minisystem/810/README.md

SYSTEM80 810
======================================

VCO/VCF/VCA in Eurorack format. Currently under development.

Hardware design by Minisystem: info@system80.net

LICENSE
=======
cc by-nc-sa
https://creativecommons.org/licenses/by-nc-sa/4.0/
