minisystem/810/Panel/810.PNG

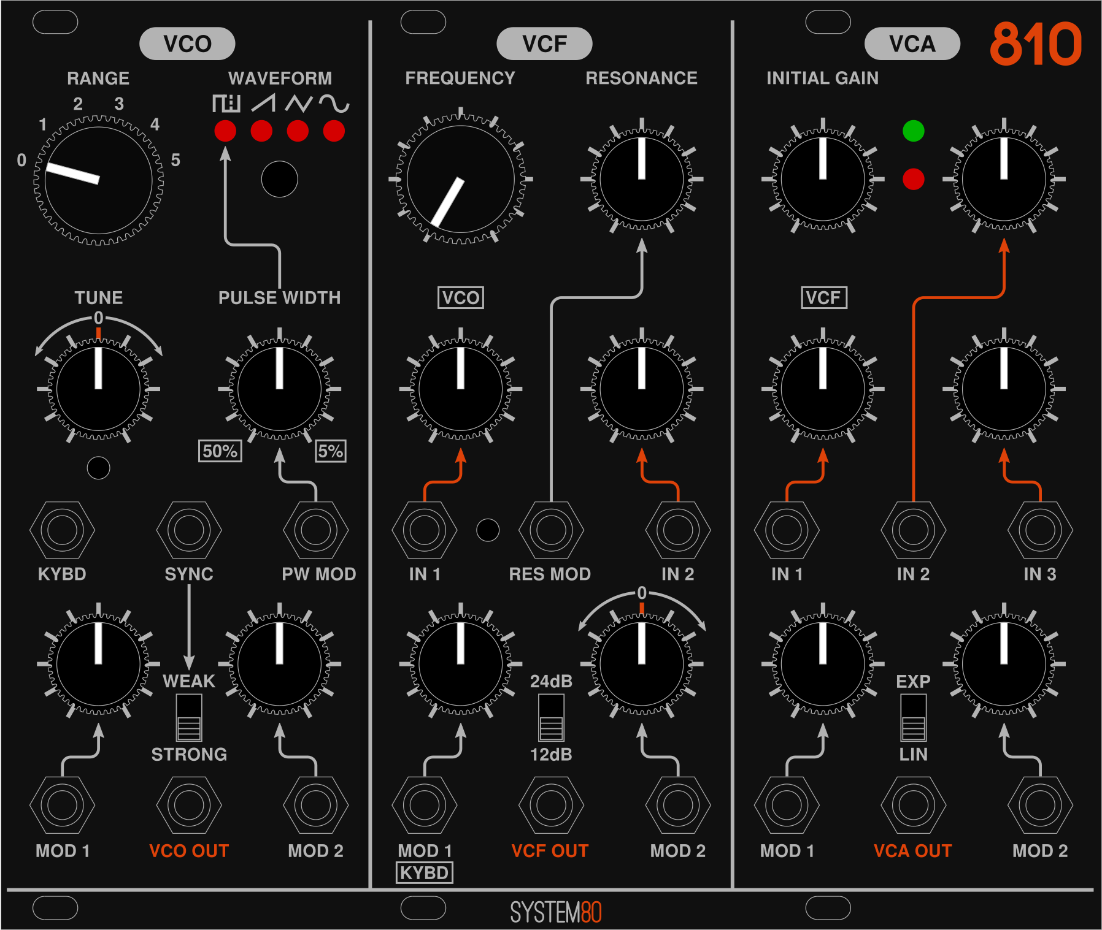
Panel/810.PNG
