minisystem/810/Panel/810_holes_centres_export_from_drawing.dxf

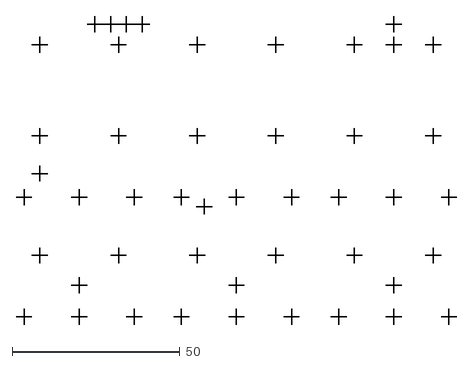
[picture p2: CAD file, 2018-02-21]
Panel/810_holes_centres_export_from_drawing.dxf
131.3 x 91.9
