minisystem/810/Panel/810_panel_mechanical.dxf

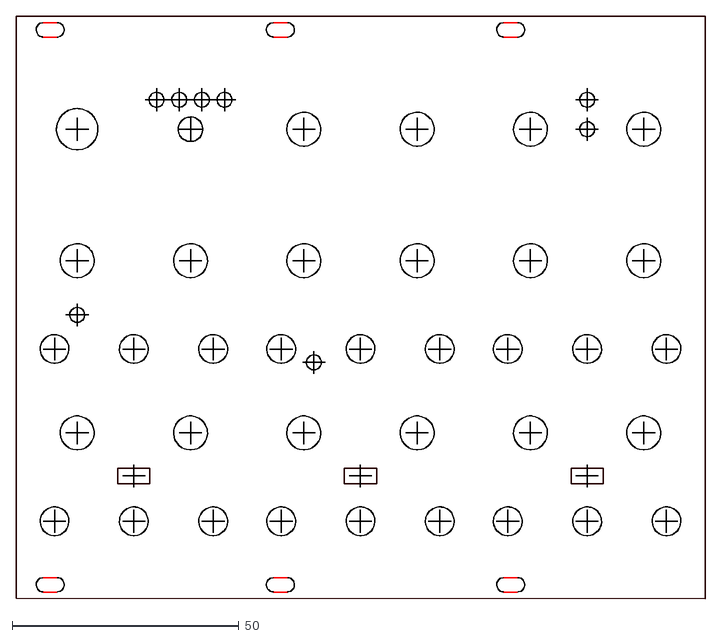
[picture p3: CAD file, 2018-02-21]
Panel/810_panel_mechanical.dxf
152.0 x 128.5
