minisystem/810/Panel/810_hole_centres.dxf

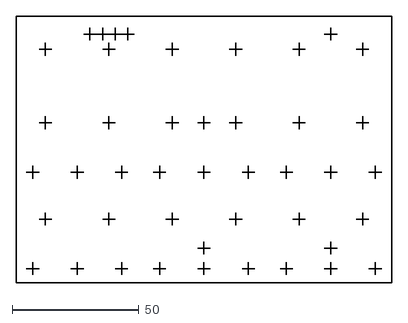
[picture p4: CAD file, 2017-09-25]
Panel/810_hole_centres.dxf
148.0 x 105.0
