minisystem/810/(list of files, cad)

Other CAD files:
Panel/810_panel_dimensioned.dwg
810-B.Paste.dxf
Panel/810_panel_mechanical.dwg
