minisystem/810/Panel/810_panel_dimensioned.pdf

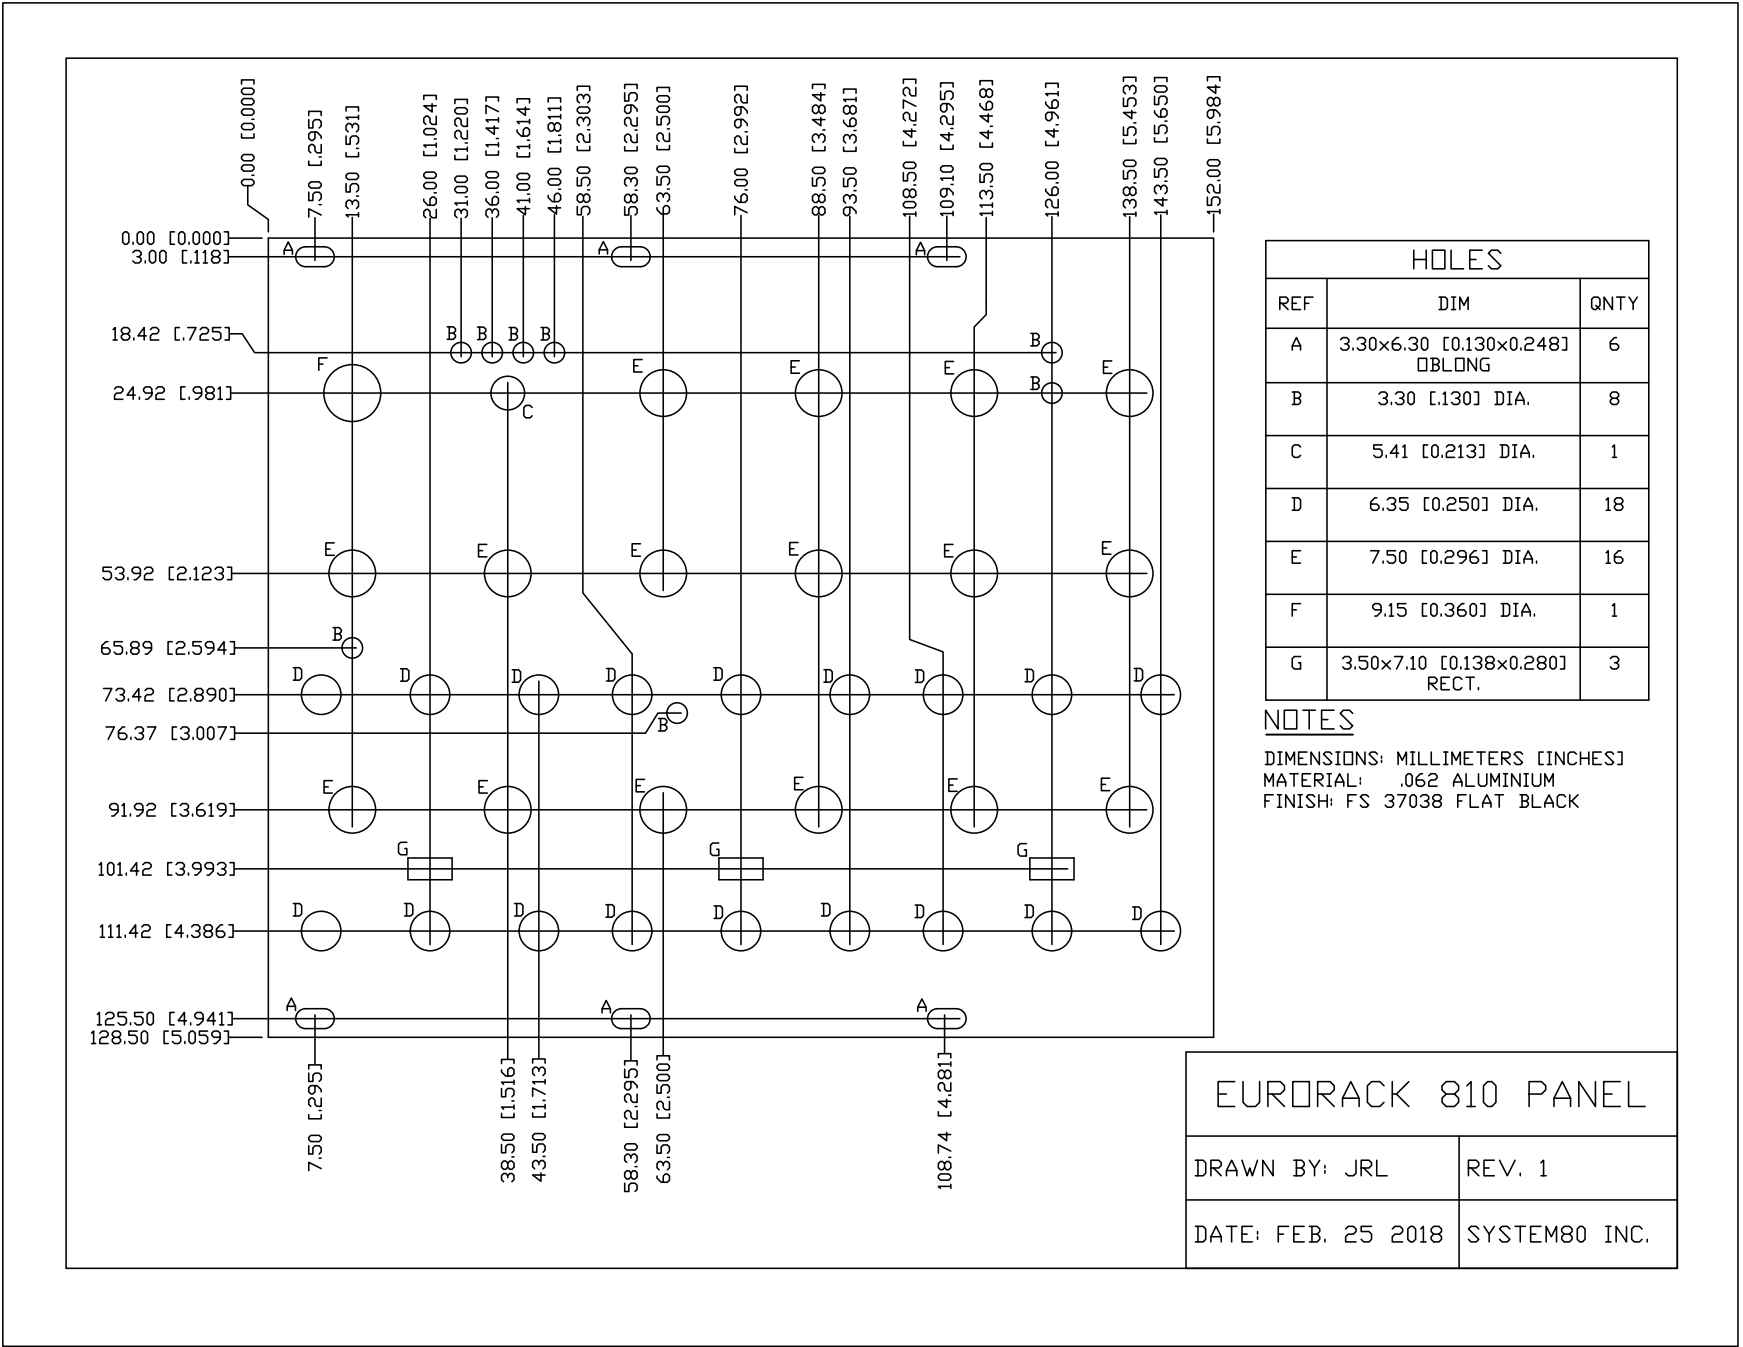
[picture p5: page 1]
