minisystem/810/Panel/810.pdf

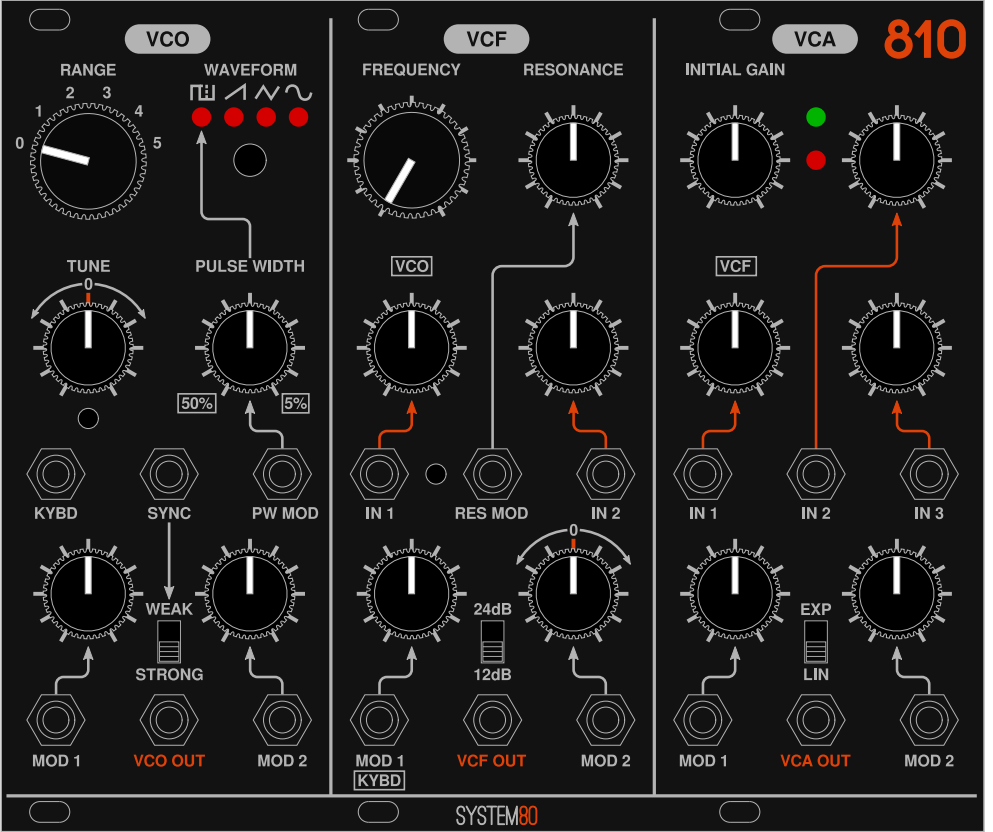
[picture p6: page 1]
