minisystem/810/Manual/810_manual_back_cover.pdf

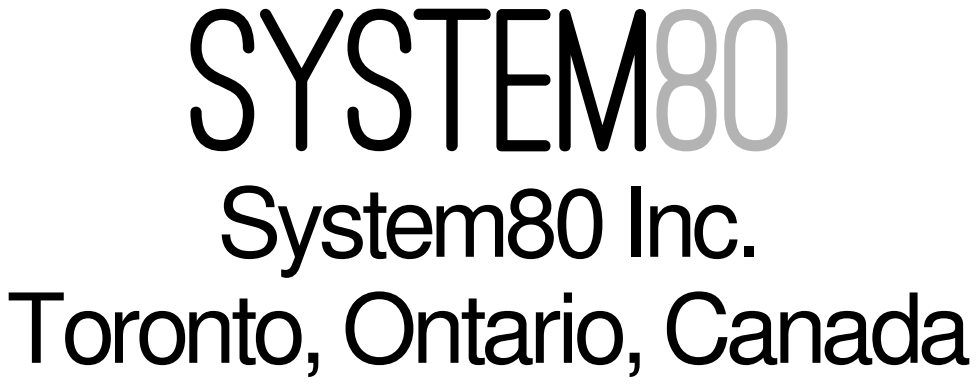
[picture p7: page 1]
