minisystem/810/Manual/810_manual_calibration.pdf

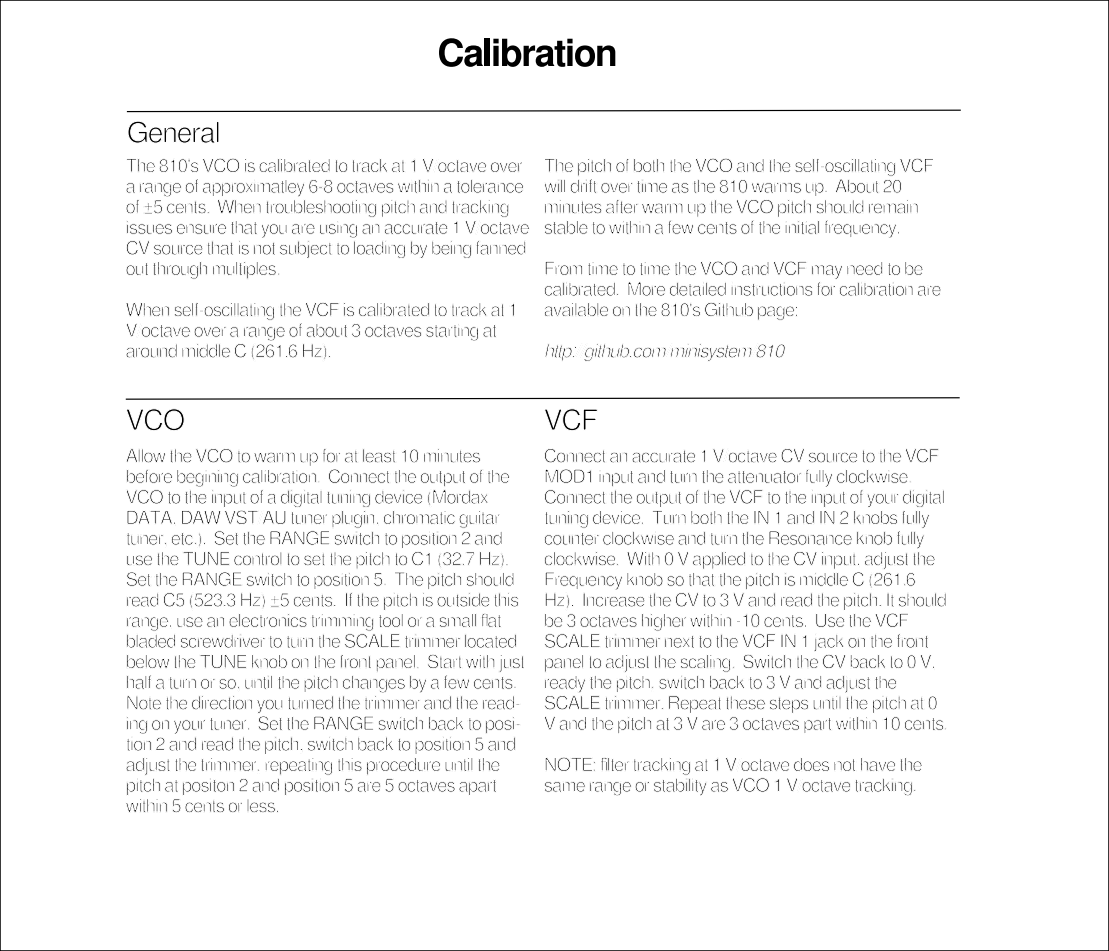
[picture p8: page 1]
