minisystem/810/Manual/810_manual_cover.pdf

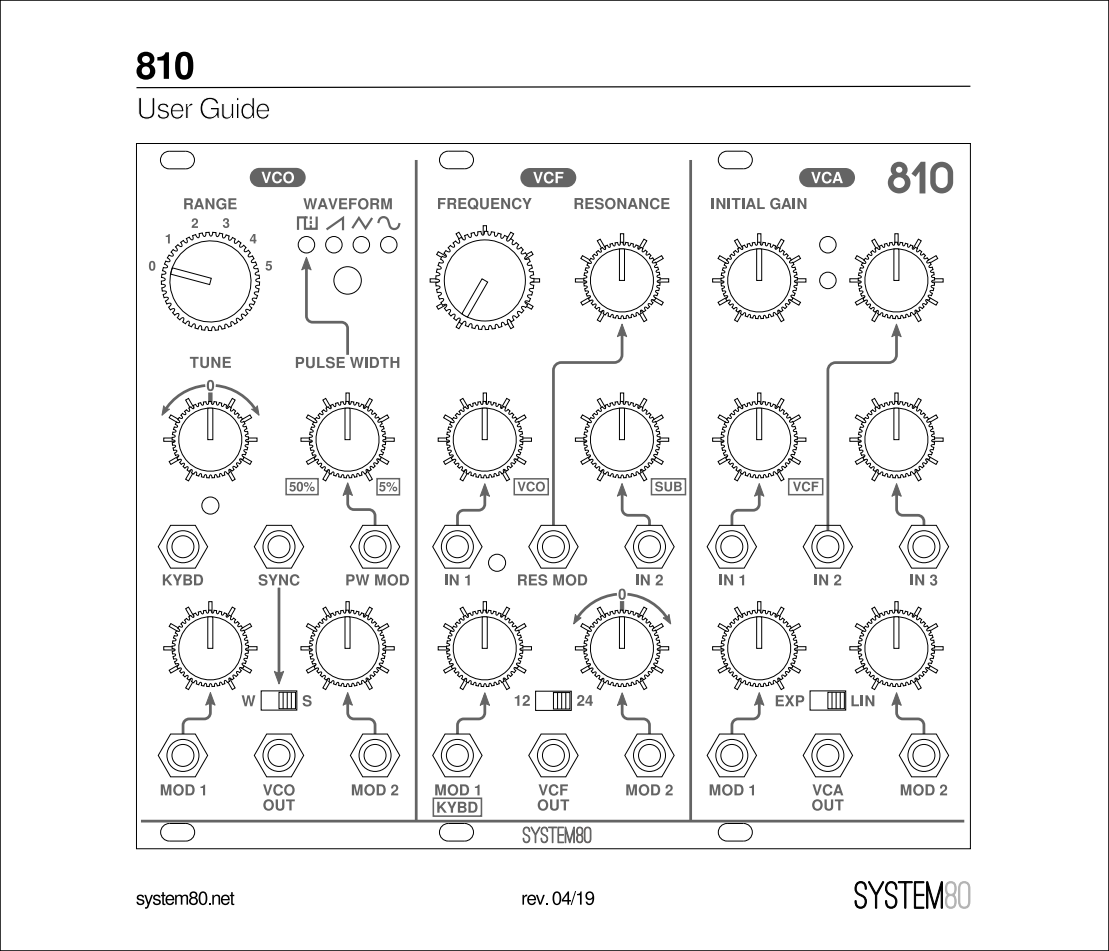
[picture p9: page 1]
