minisystem/810/Manual/810_manual_overview.pdf

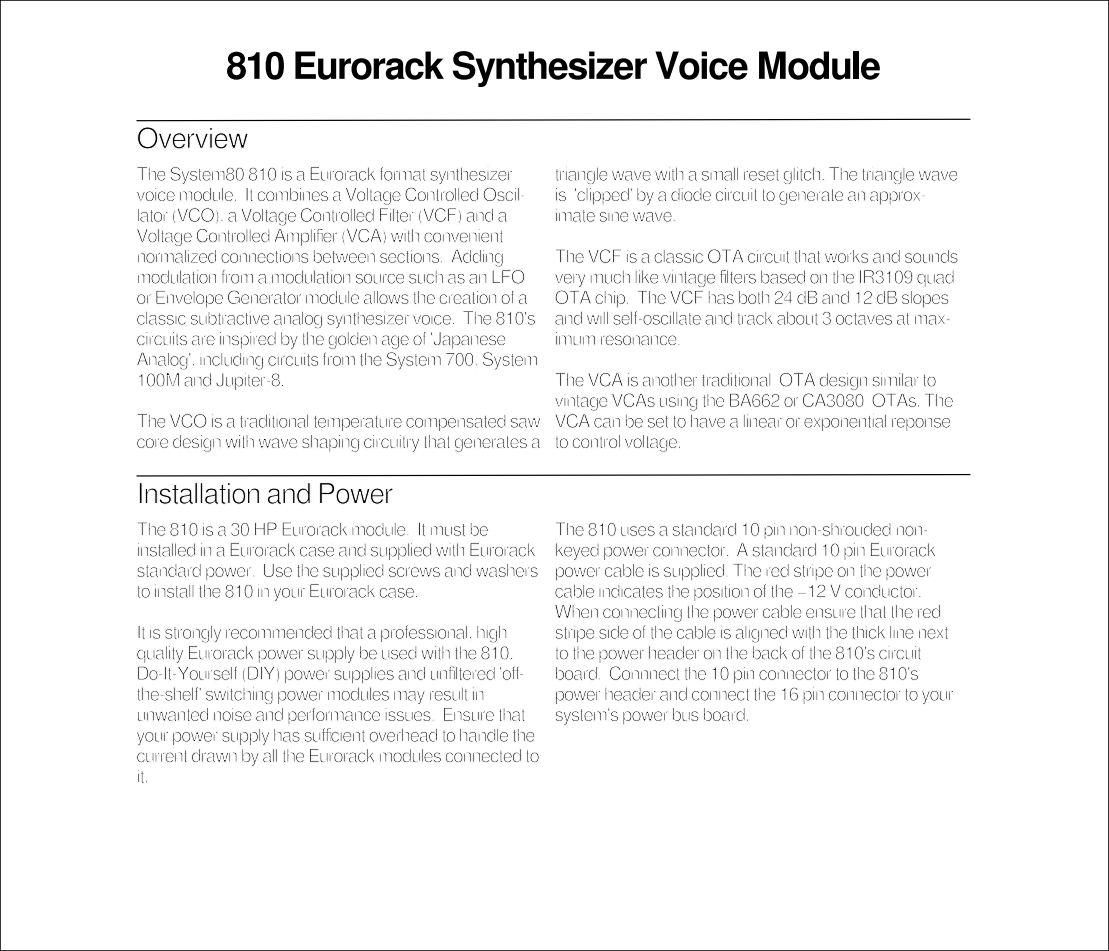
[picture p10: page 1]
