minisystem/810/Manual/810_manual_specifications.pdf

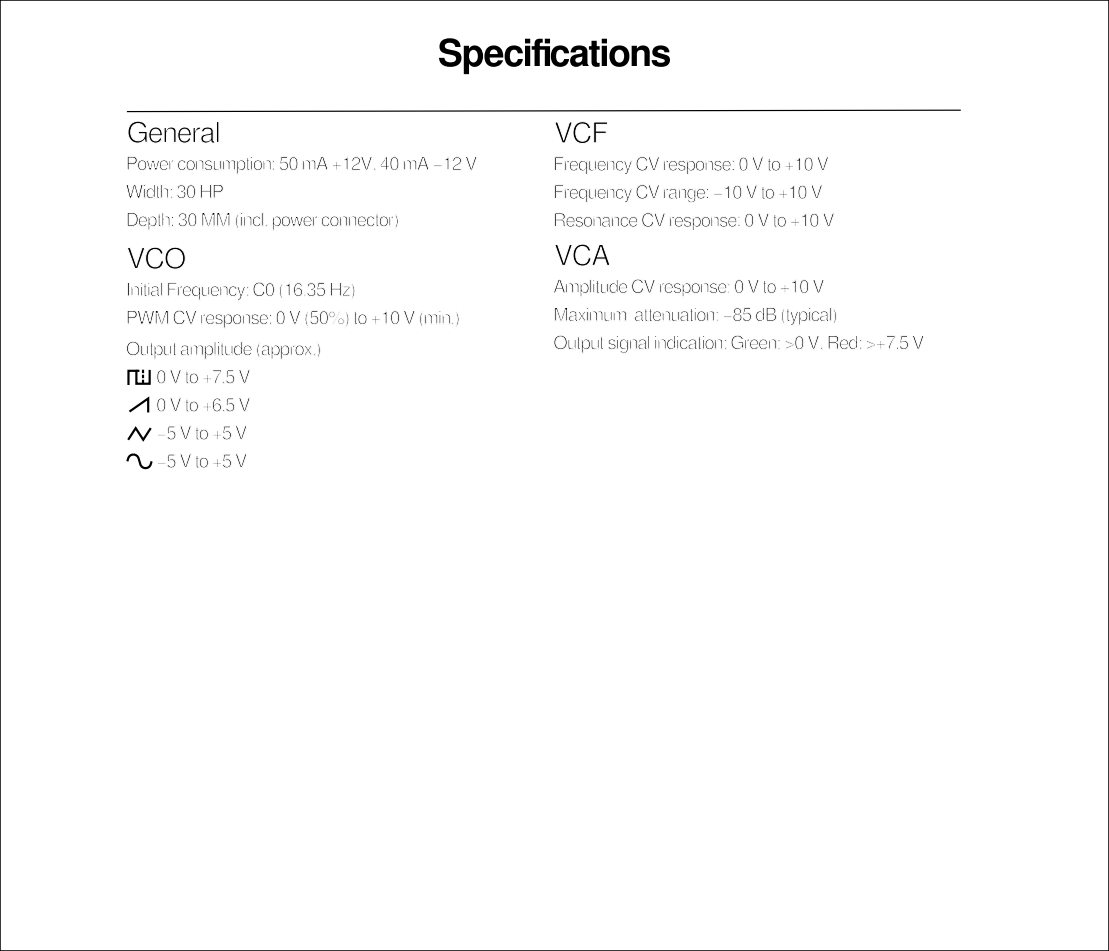
[picture p11: page 1]
