minisystem/810/Manual/810_manual_vca.pdf

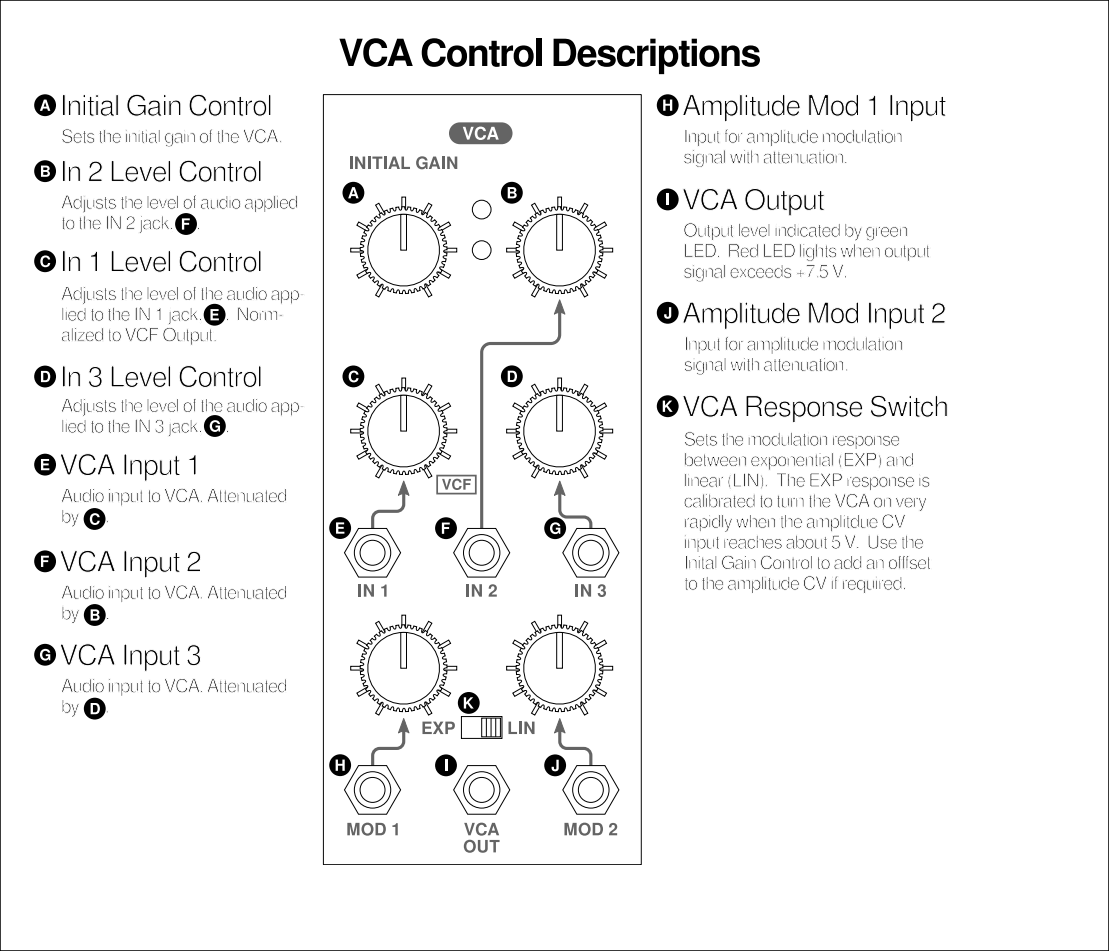
[picture p12: page 1]
