minisystem/810/Manual/810_manual_vcf.pdf

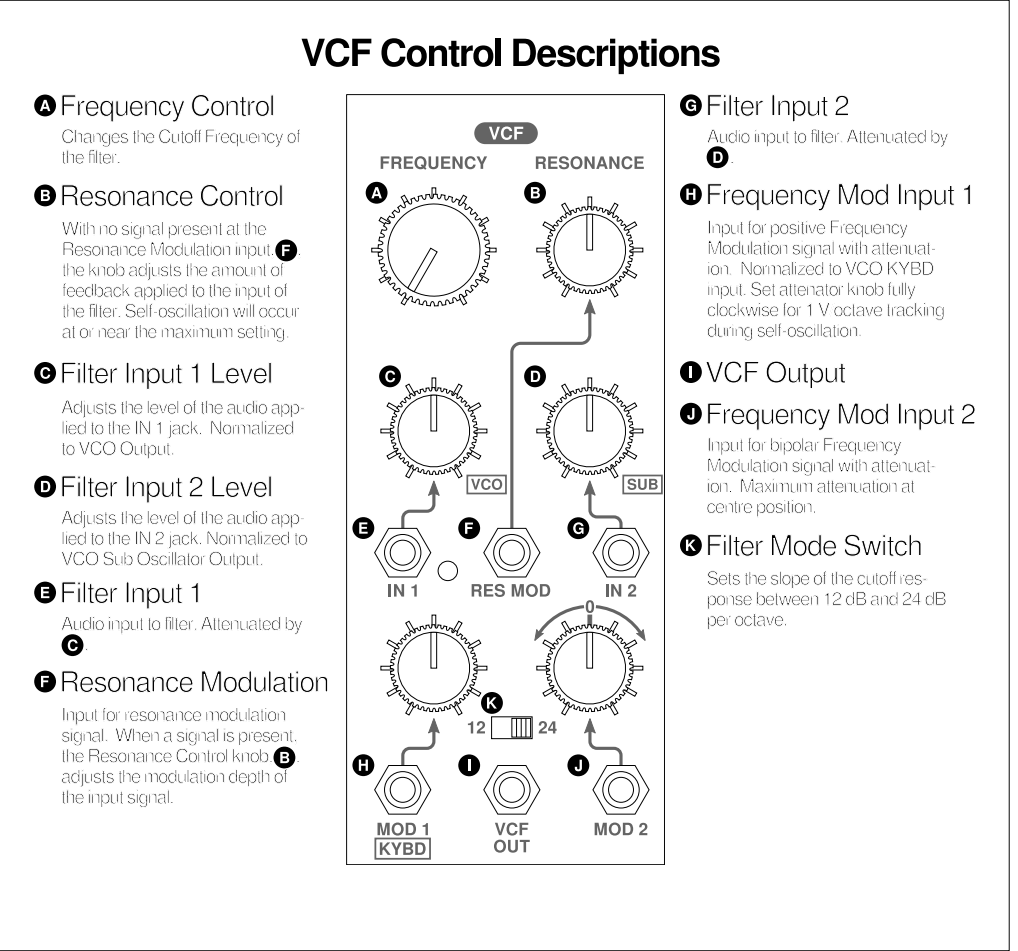
[picture p13: page 1]
