minisystem/810/Manual/810_manual_vco.pdf

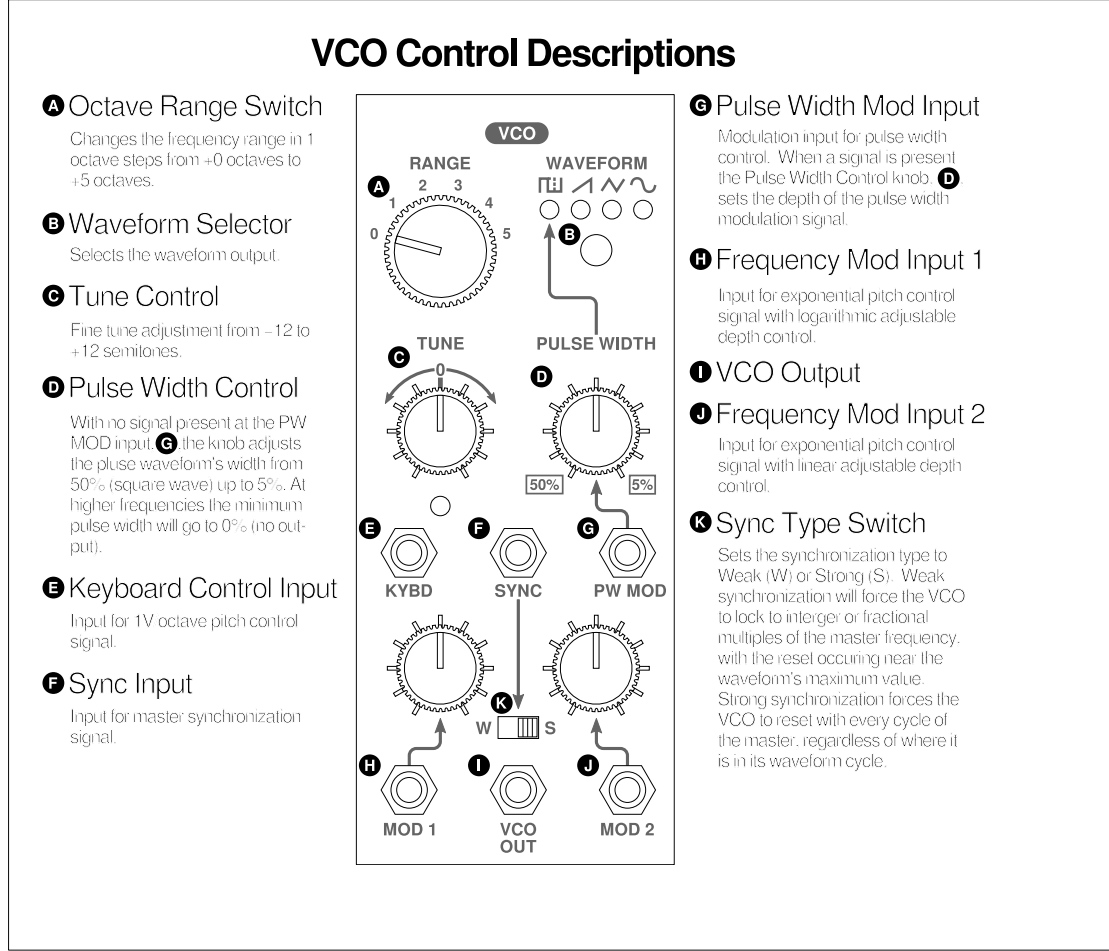
[picture p14: page 1]
