minisystem/810/810.kicad_pcb

## KiCad design 810.kicad_pcb (2018-04-28)

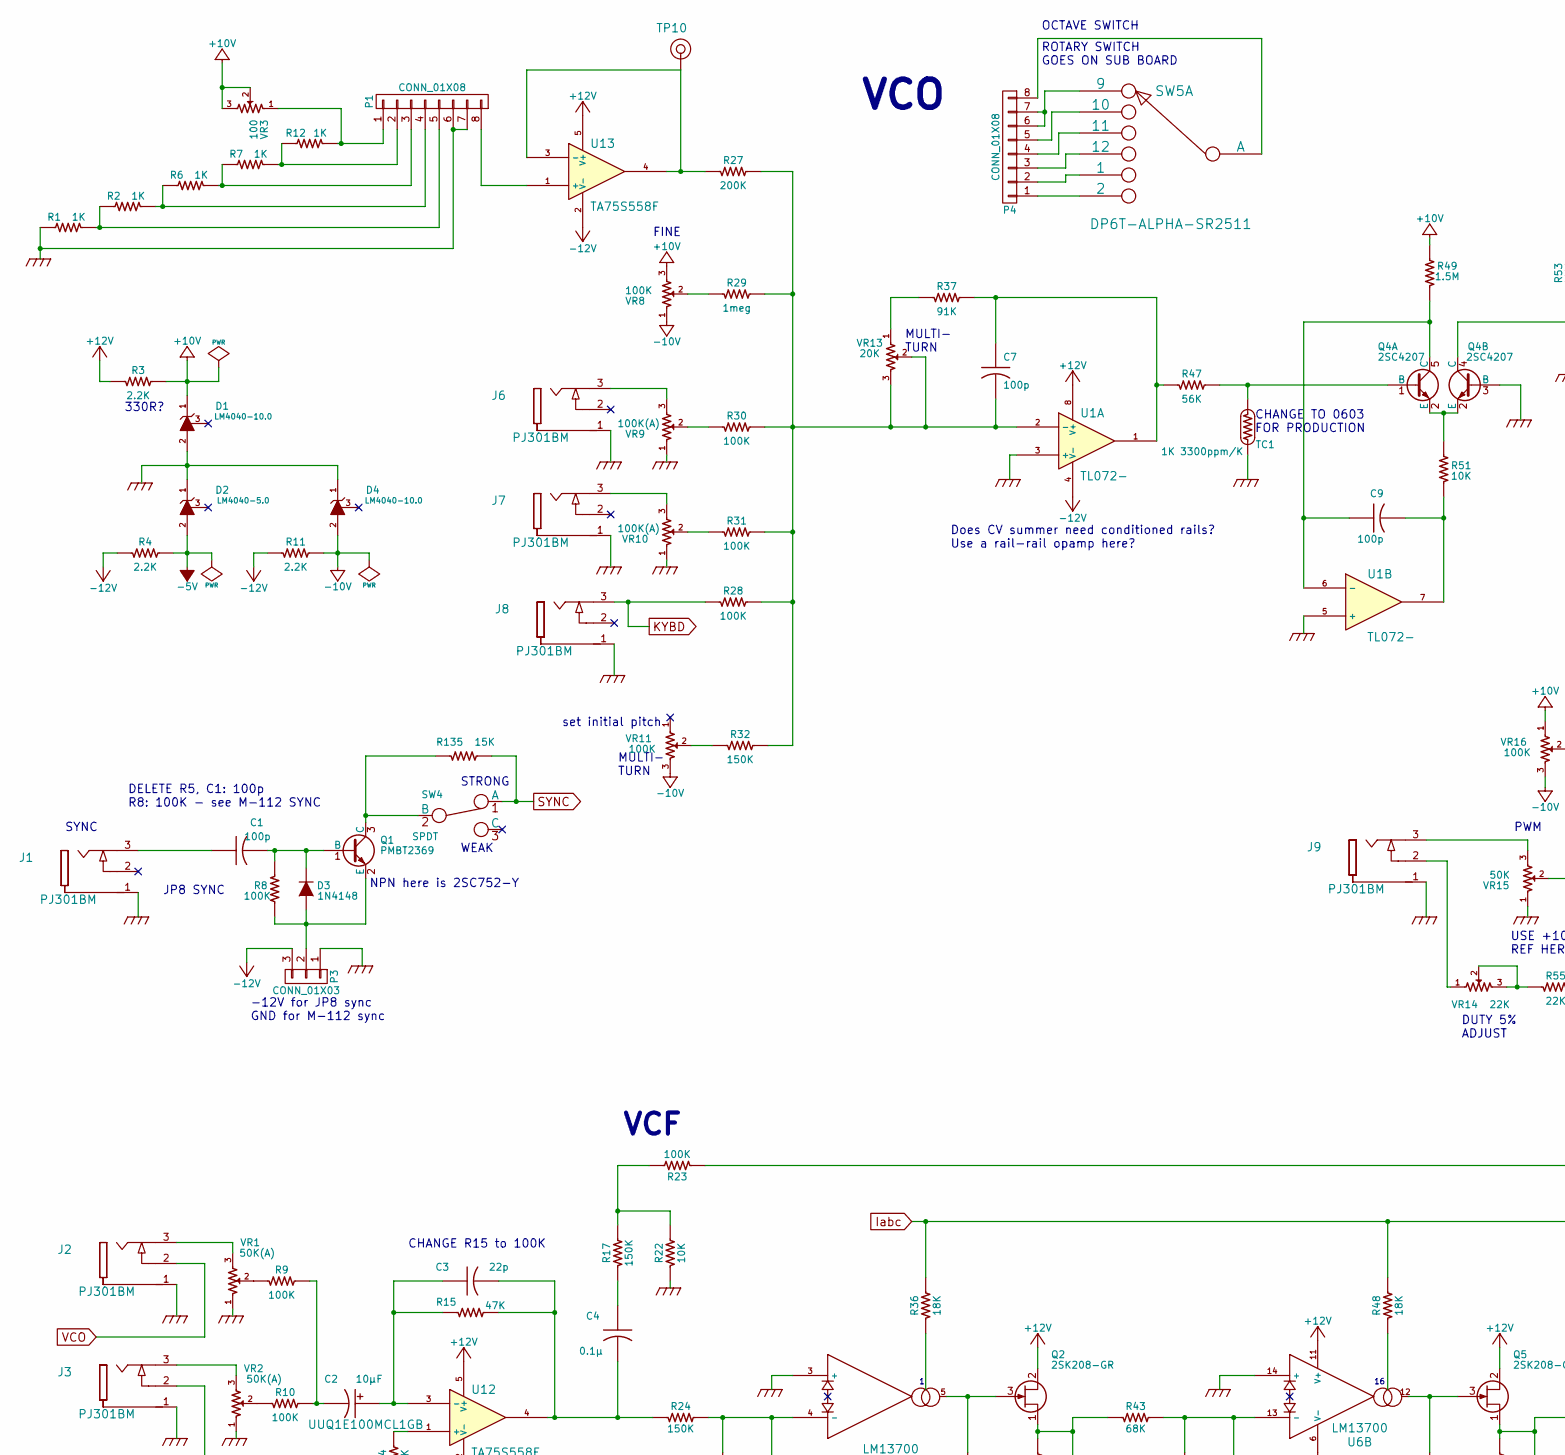
[picture p15: schematic 810.sch, part in row 1, column 1]

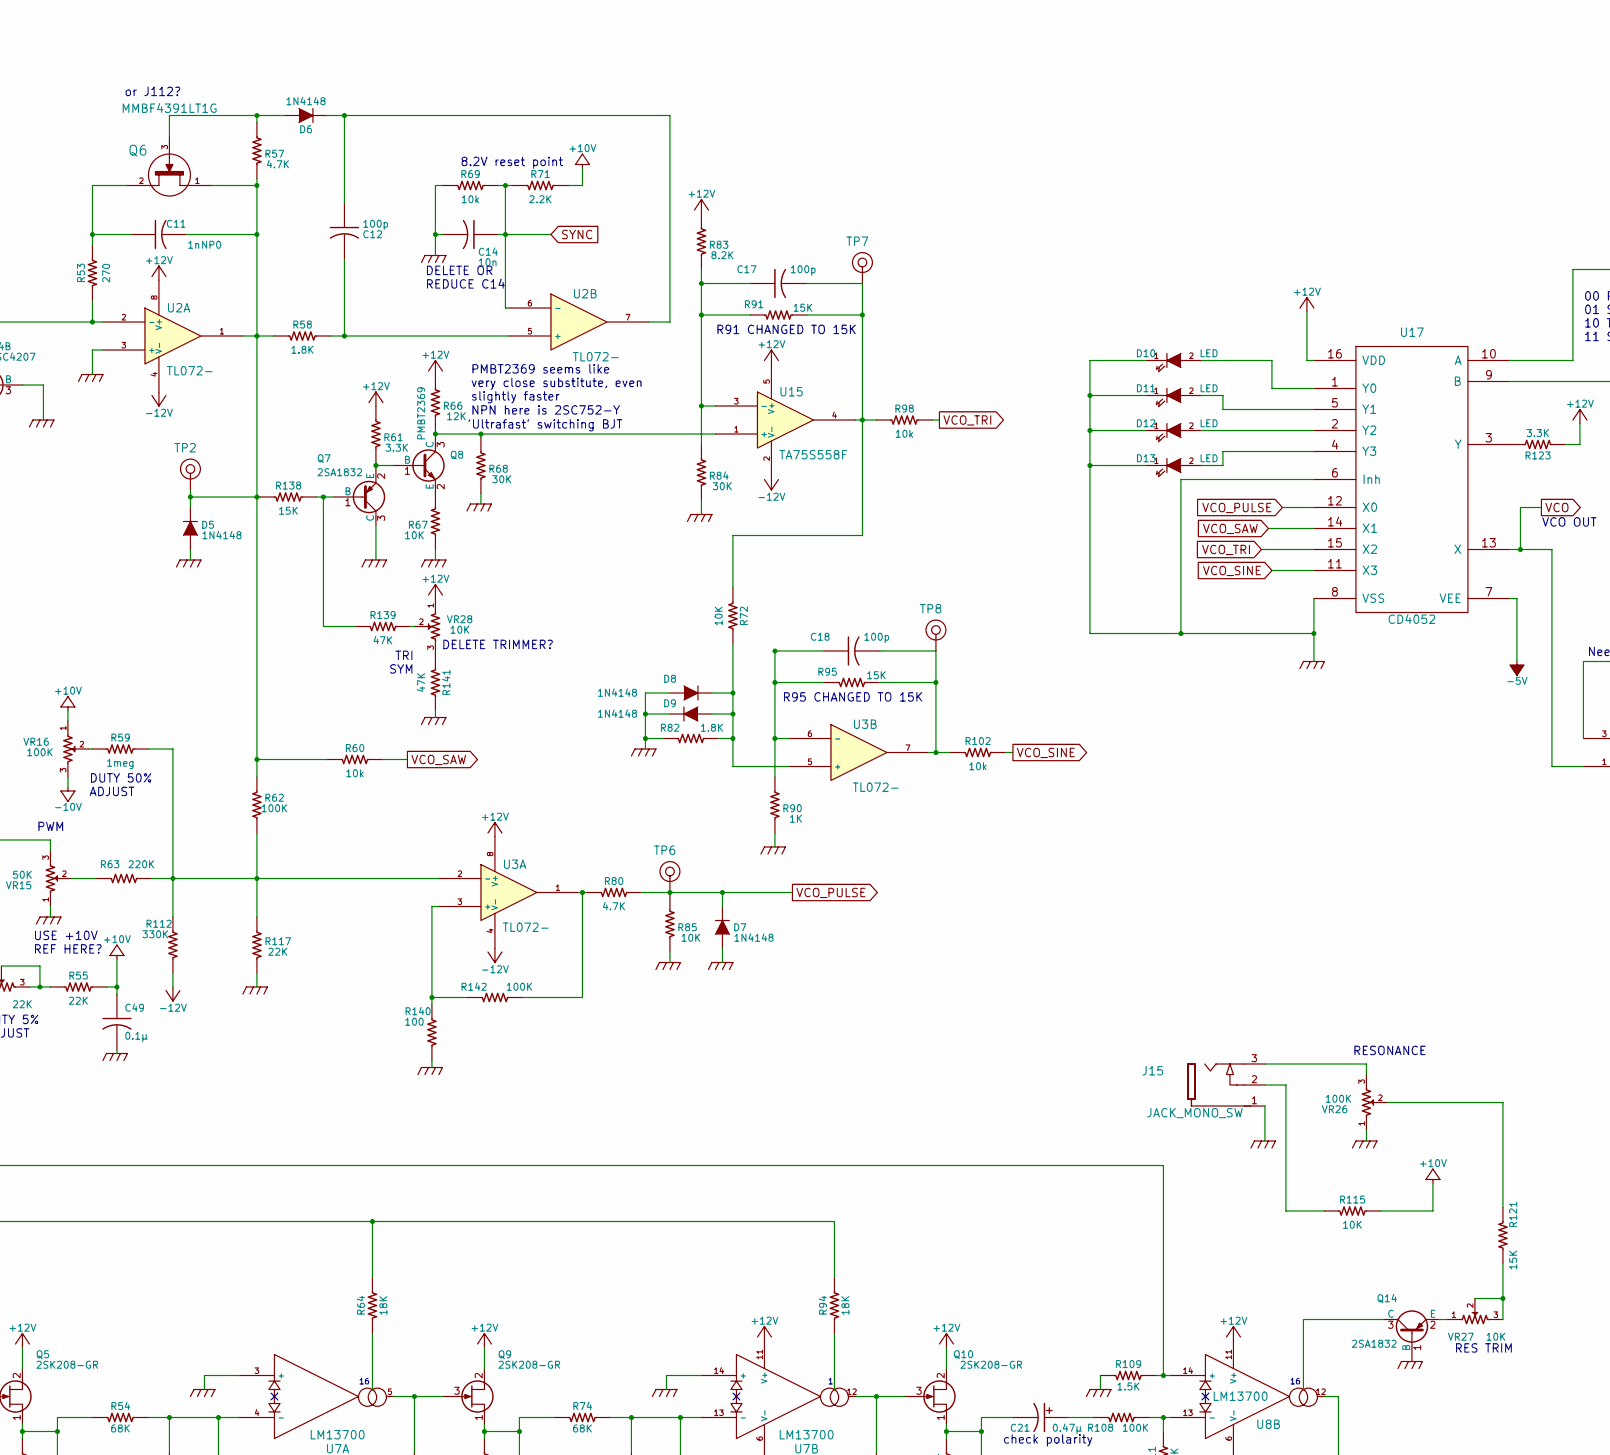
[picture p16: schematic 810.sch, part in row 1, column 2]

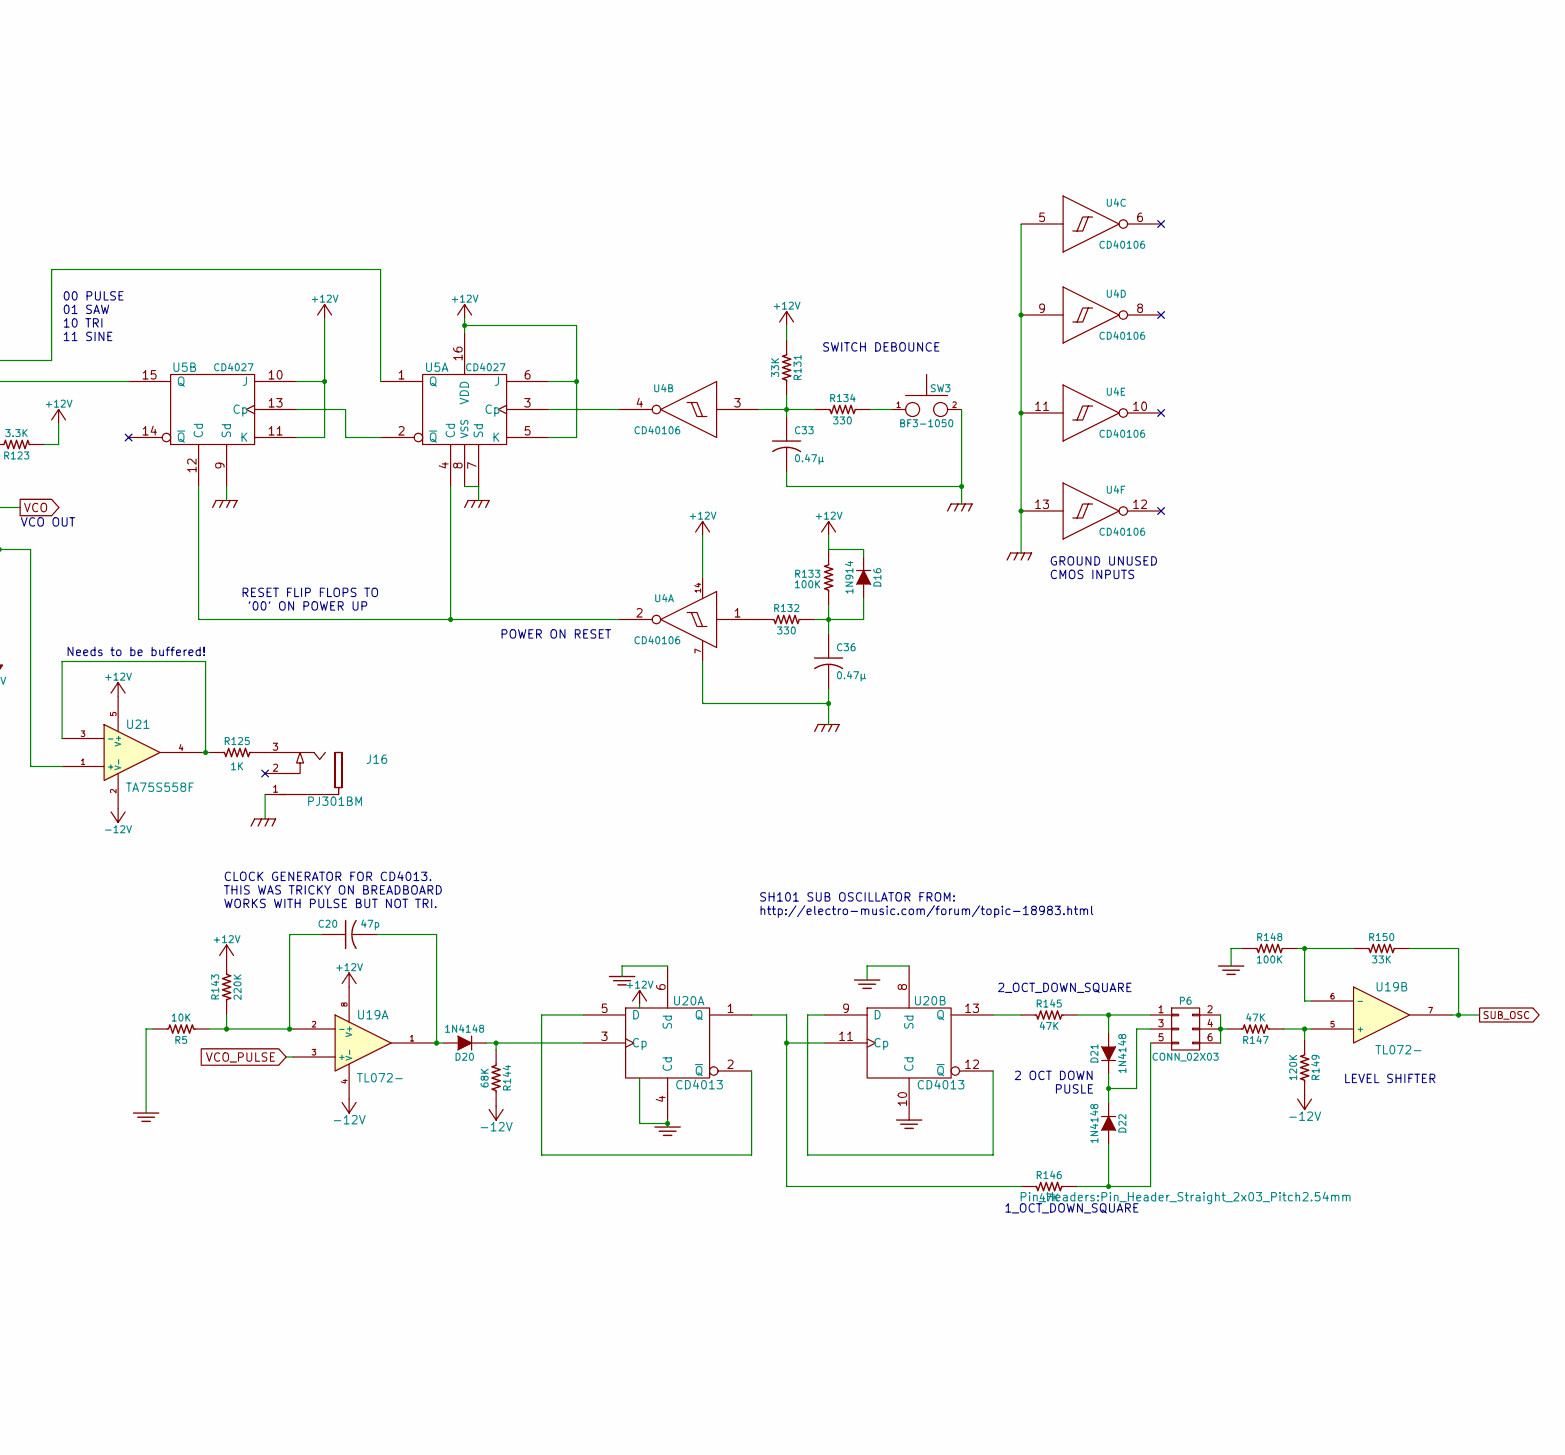
[picture p17: schematic 810.sch, part in row 1, column 3]

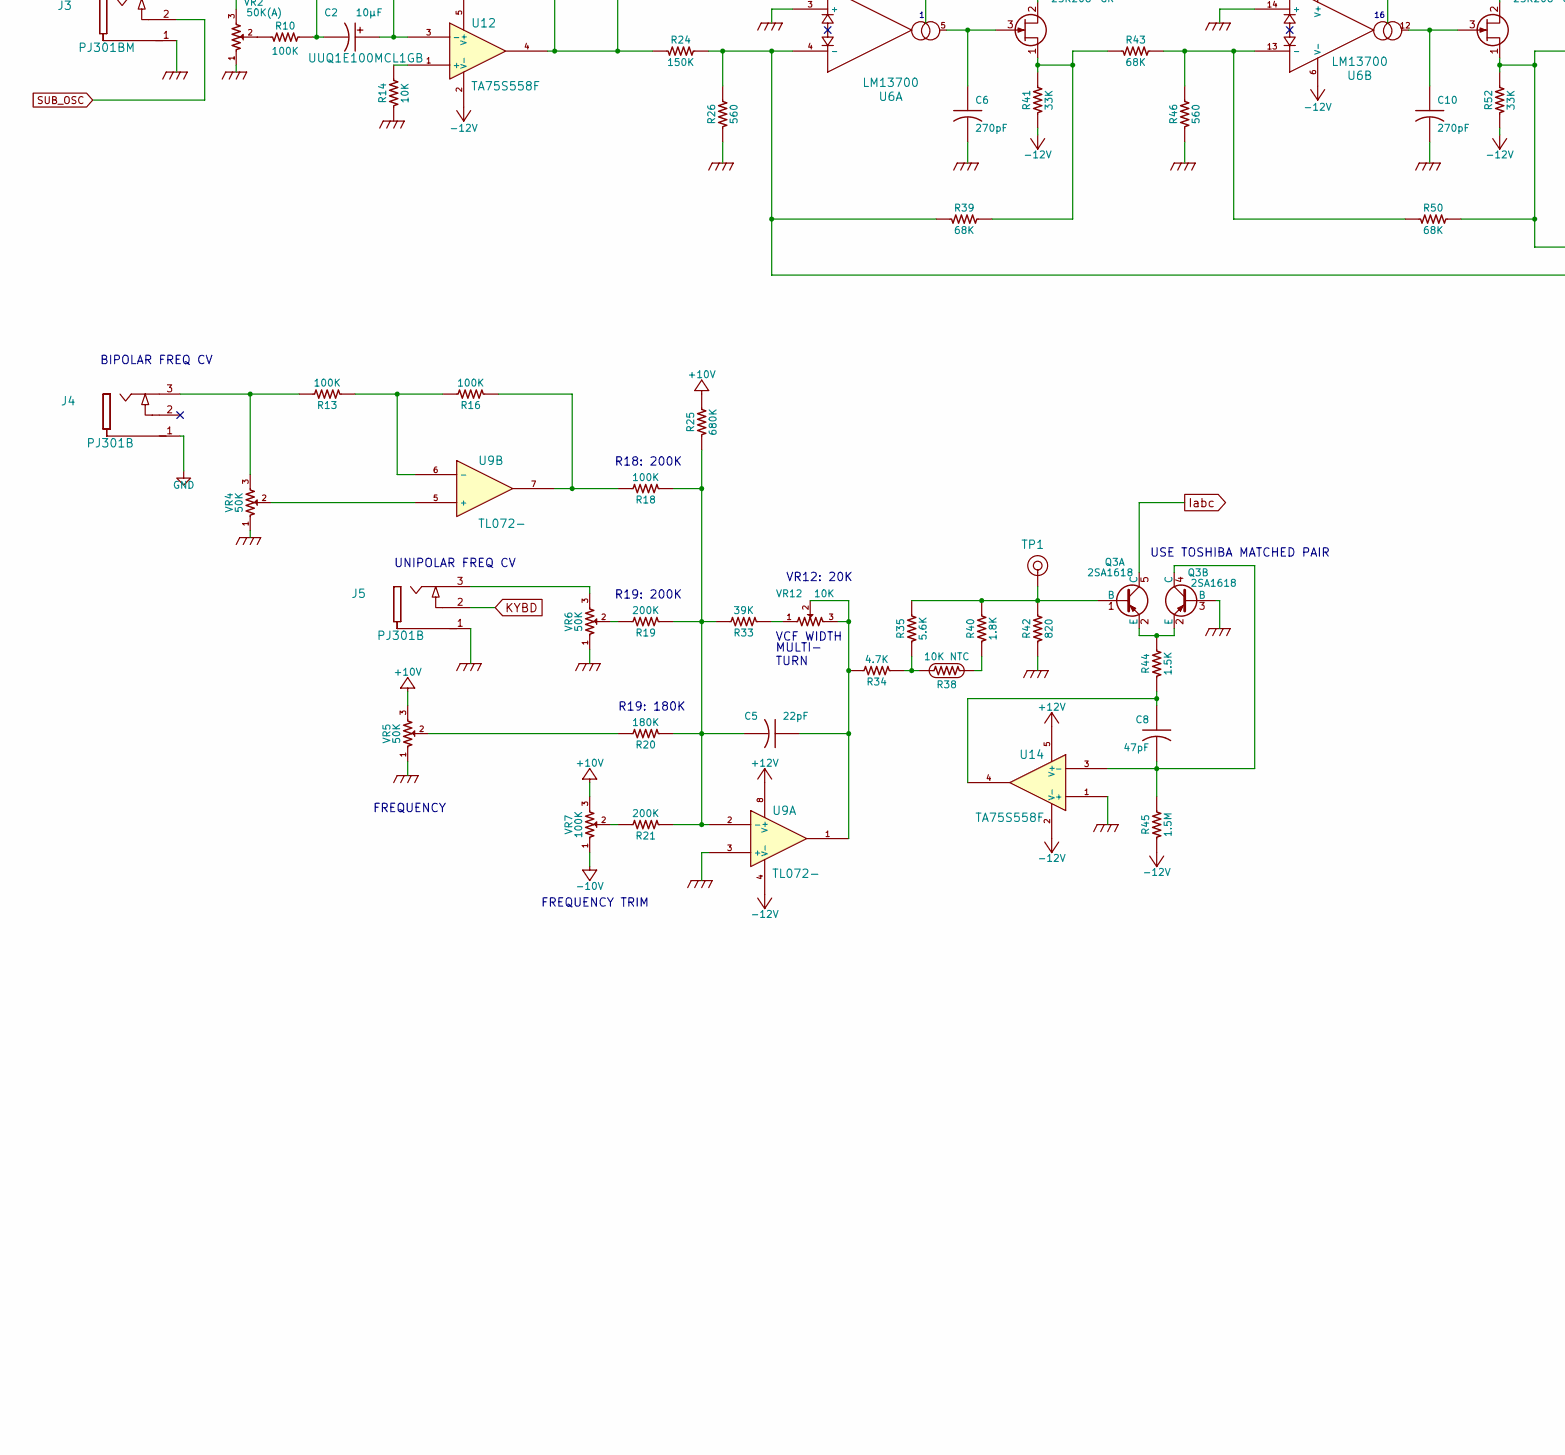
[picture p18: schematic 810.sch, part in row 2, column 1]

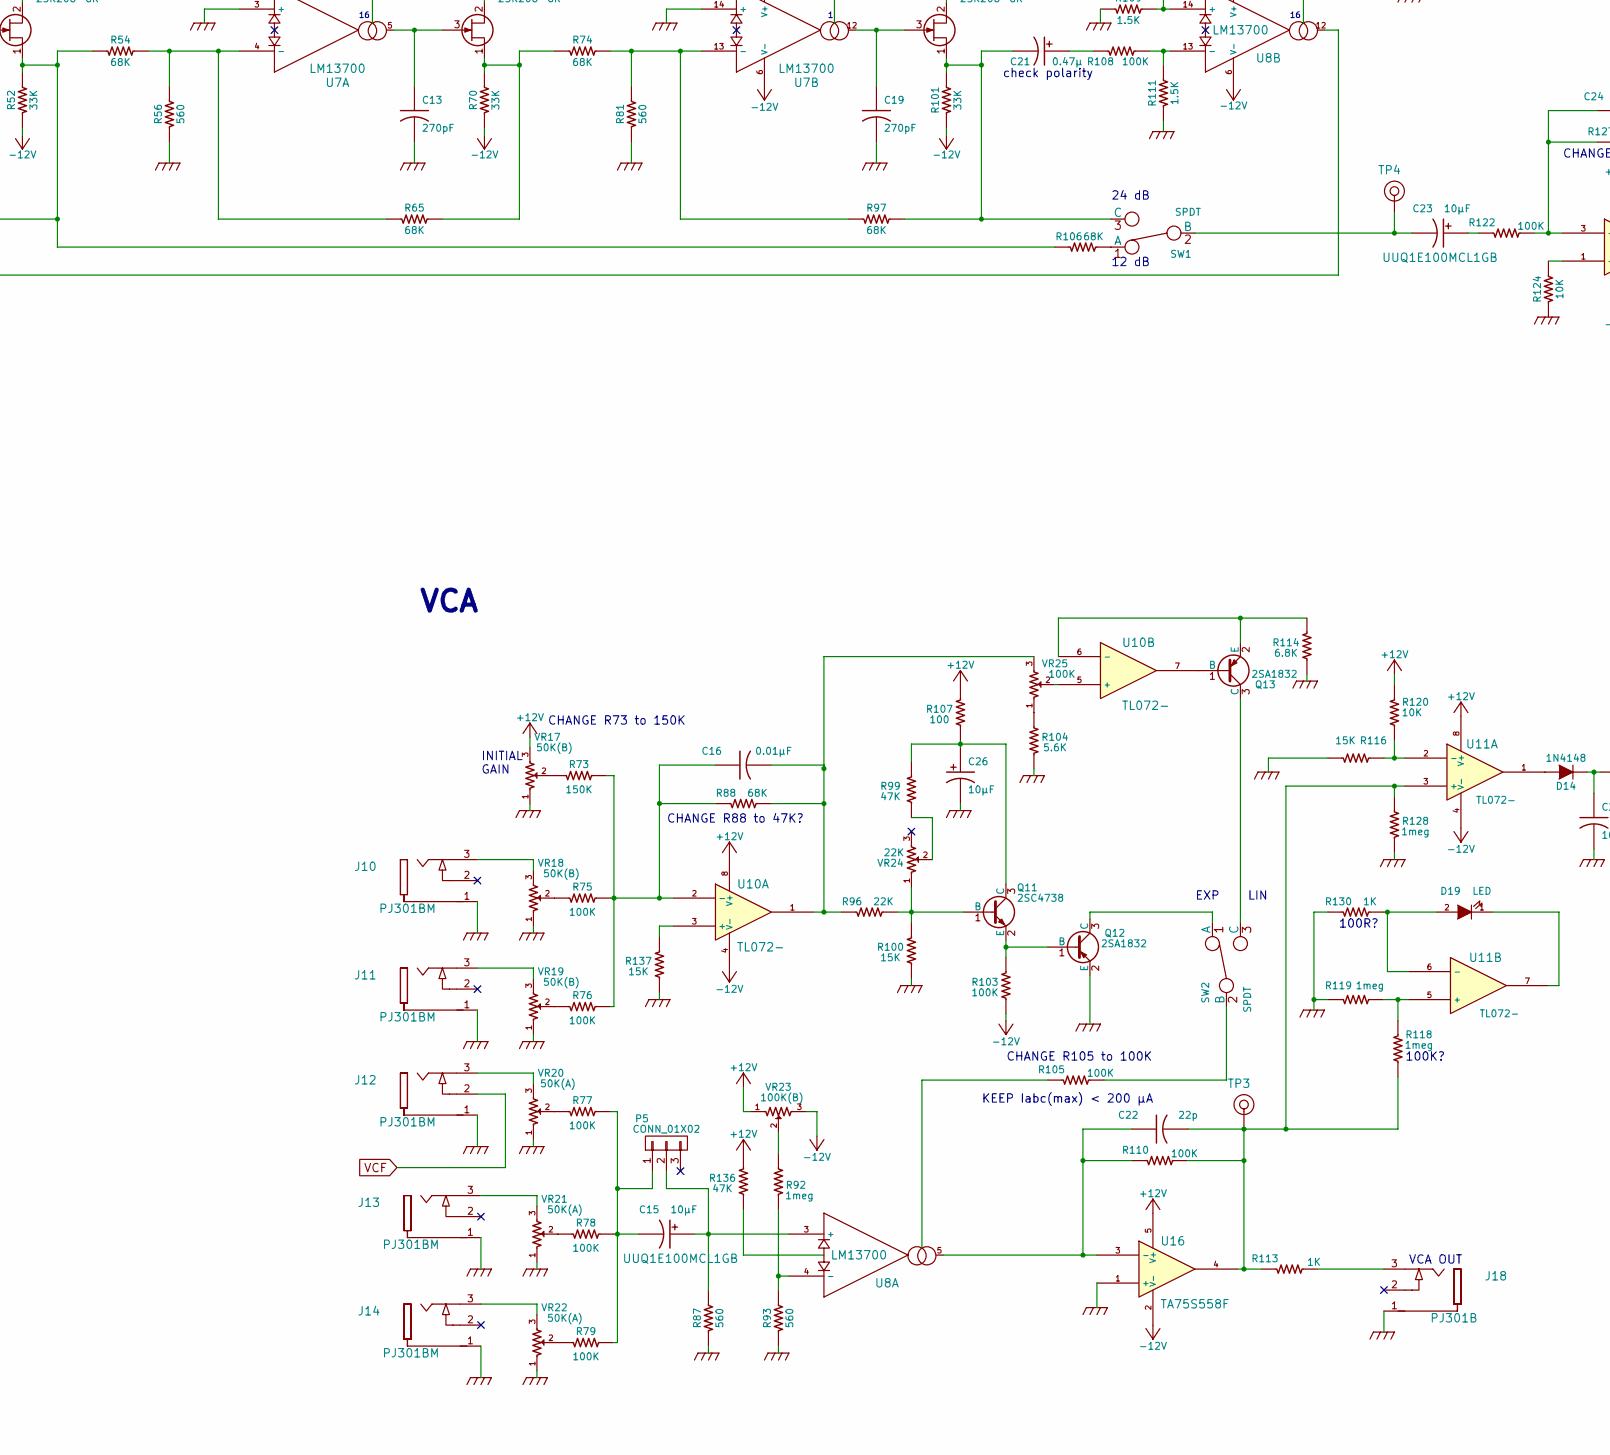
[picture p19: schematic 810.sch, part in row 2, column 2]

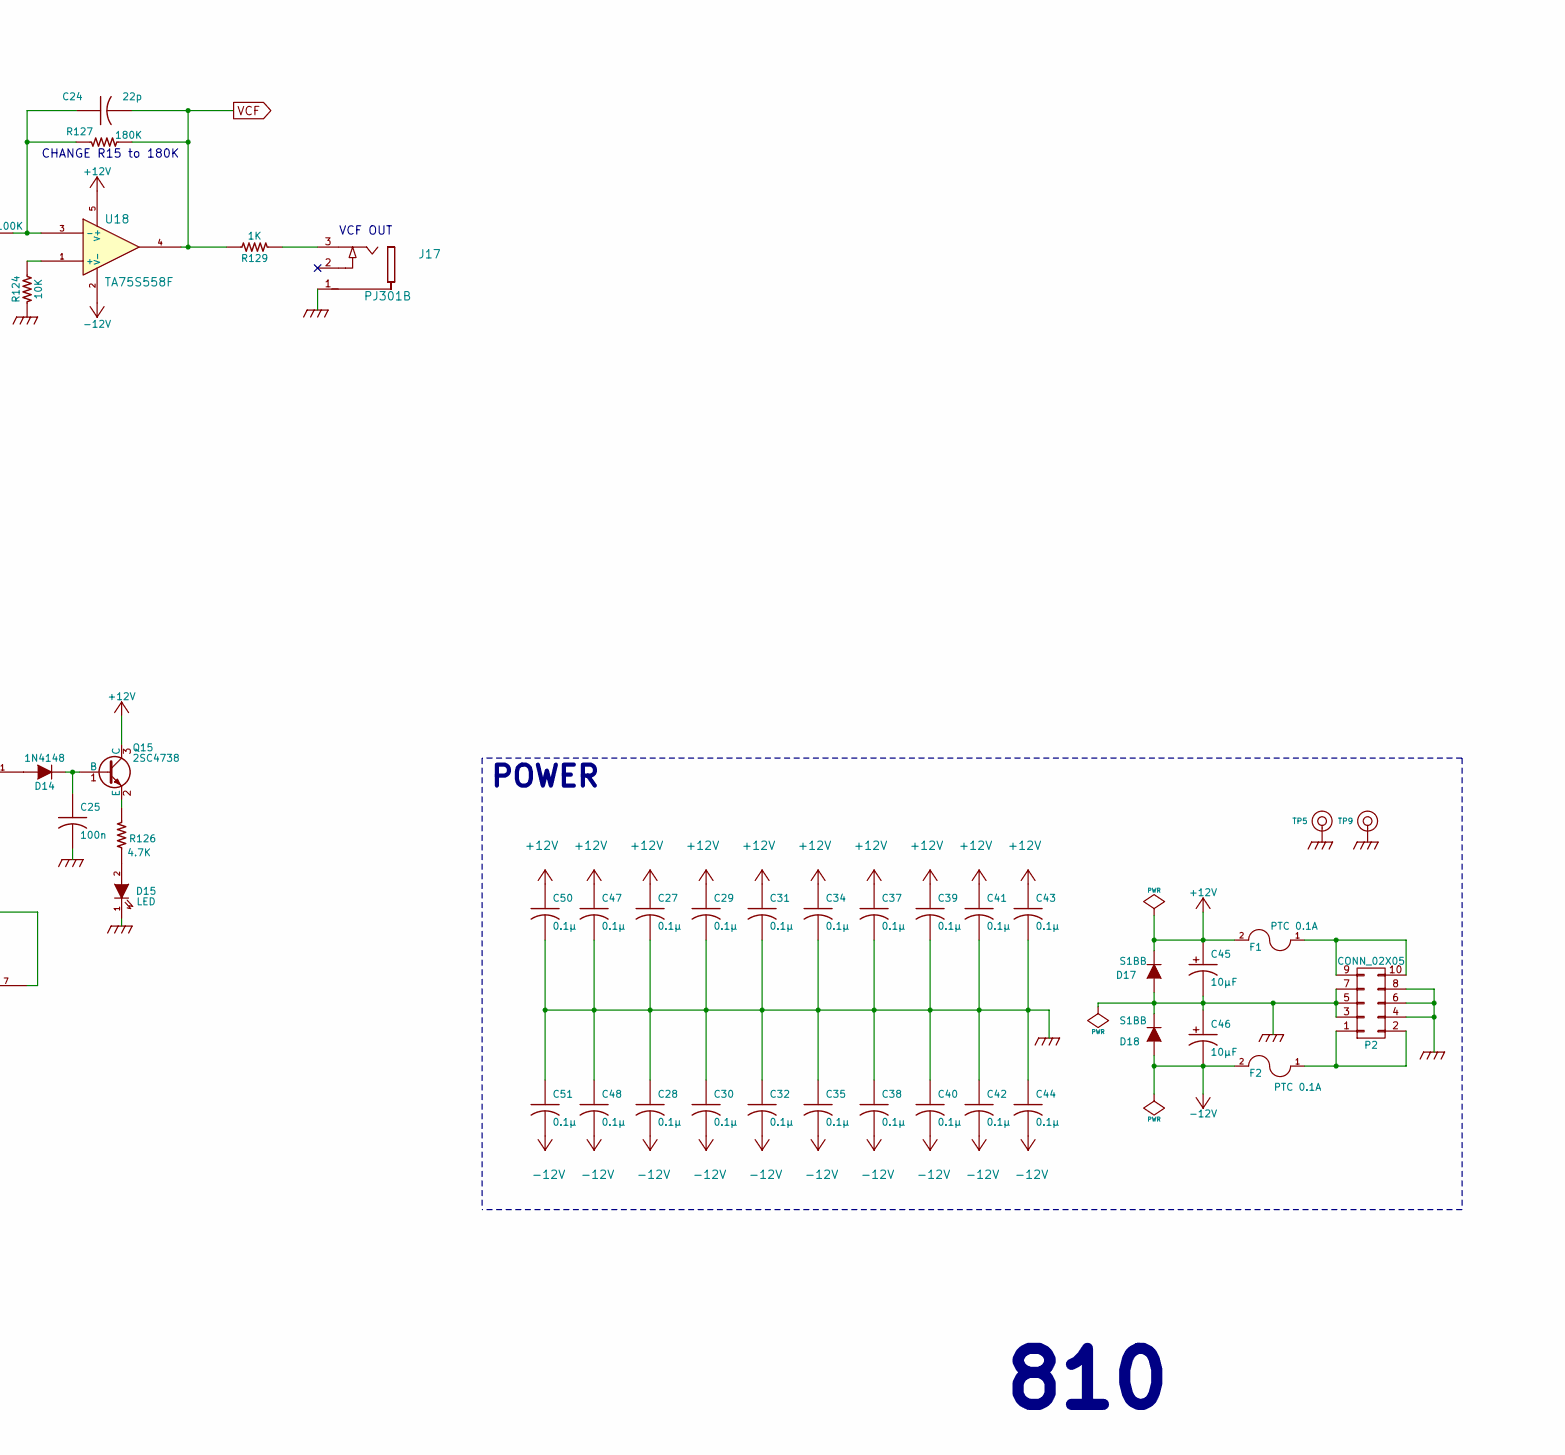
[picture p20: schematic 810.sch, part in row 2, column 3]

Parts:
C1, C12, C17, C18: 100p; SM0603-C-JRL
C2, C15, C23: 10μF; jrl_c_elec_5x5.3; Part Number UUQ1E100MCL1GB
C3, C22, C24: 22p; SM0603-C-JRL
C4: 0.1μ; SM0603-C-JRL
C5: 22pF; SM0603-C-JRL
C6, C10, C13, C19: 270pF; SM0603-C-JRL
C7, C9: 100p; SM0603-C-JRL; Digikey 399-1122-1-ND
C8: 47pF; SM0603-C-JRL
C11: 1n; SM0603-C-JRL
C14: 10n; SM0603-C-JRL
C16: 0.01μF; SM0603-C-JRL
C20: 47p; SM0603-C-JRL
C21: 0.47μ; jrl_c_elec_4x5.3
C25: 100n; SM0603-C-JRL
C26, C45, C46: 10μF; jrl_c_elec_5x5.3
C27, C28, C29, C30, C31, C32, C34, C35, C37, C38, C39, C40, C41, C42, C43, C44, C47, C48, C49, C50, C51: 0.1µ; SM0603-C-JRL
C33, C36: 0.47μ; SM0603-C-JRL
D1, D4: LM4040-10.0; SOT23-132-JRL
D2: LM4040-5.0; SOT23-132-JRL
D3, D5, D6, D7, D8, D9, D14, D20, D21, D22: 1N4148; SOD323-C1A2
D10, D11, D12, D13, D15, D19: LED; 3MM-LED-C1A2
D16: 1N914; SOD323-C1A2
D17, D18: S1BB; SMB-1C2A
F1, F2: PTC 0.1A; C_0805
J1, J2, J3, J6, J7, J8, J9, J10, J11, J12, J13, J14, J16: PJ301BM; PJ-301B-JACK-SLOTS
J4, J5, J17, J18: PJ301B; PJ-301B-JACK-SLOTS
J15: JACK_MONO_SW; PJ-301B-JACK-SLOTS
P1, P4: CONN_01X08; Pin_Header_Straight_1x08_Pitch2.54mm
P2: CONN_02X05; Pin_Header_Straight_2x05_Pitch2.54mm
P3: CONN_01X03; Pin_Header_Straight_1x03_Pitch2.54mm
P5: CONN_01X02; Pin_Header_Straight_1x03_Pitch2.54mm
P6: CONN_02X03; Pin_Header_Straight_2x03_Pitch2.54mm
Q1: PMBT2369; SOT-23
Q2, Q9, Q10: 2SK208-GR; SOT-23
Q3: 2SA1618; SOT753_TSOP5_SC-74A
Q4: 2SC4207; SOT753_TSOP5_SC-74A
Q5: 2SK208-GR; SC-59
Q6: MMBF4391LT1G; SOT23-132-JRL
Q7, Q12, Q13, Q14: 2SA1832; SOT416-SC75
Q8: PMBT2369; SOT23-132-JRL
Q11, Q15: 2SC4738; SOT416-SC75
R1, R2, R6, R7, R12, R129: 1K; SM0603-R-JRL
R3, R4, R11, R71: 2.2K; SM0603-R-JRL; Digikey P10.0KCCT-ND
R5, R14, R22, R124: 10K; SM0603-R-JRL
R8, R62, R105, R110, R122, R142: 100K; SM0603-R-JRL; Digikey P10.0KCCT-ND
R9, R10, R28, R30, R31, R75, R76, R77, R78, R79: 100K; SM0603-R-JRL; Digikey P91.0KCCT-ND
R13, R16, R18, R23, R103, R108, R133, R148: 100K; SM0603-R-JRL
R15, R139, R141: 47K; SM0603-R-JRL; Digikey P10.0KCCT-ND
R17, R24: 150K; SM0603-R-JRL
R19, R21: 200K; SM0603-R-JRL
R20: 180K; SM0603-R-JRL
R25: 680K; SM0603-R-JRL
R26, R46, R56, R81, R87, R93: 560; SM0603-R-JRL
R27: 200K; SM0603-R-JRL; Digikey P91.0KCCT-ND
R29: 1meg; SM0603-R-JRL; Digikey P91.0KCCT-ND
R32, R73: 150K; SM0603-R-JRL; Digikey P91.0KCCT-ND
R33: 39K; SM0603-R-JRL
R34: 4.7K; SM0603-R-JRL
R35, R104: 5.6K; SM0603-R-JRL
R36, R48, R64, R94: 18K; SM0603-R-JRL
R37: 91K; SM0603-R-JRL; Digikey P91.0KCCT-ND
R38: 10K NTC; SM0805-HAND
R39, R43, R50, R54, R65, R74, R97, R106, R144: 68K; SM0603-R-JRL
R40: 1.8K; SM0603-R-JRL
R41, R52, R70, R101, R131, R150: 33K; SM0603-R-JRL
R42: 820; SM0603-R-JRL
R44, R109, R111: 1.5K; SM0603-R-JRL
R45: 1.5M; SM0603-R-JRL
R47: 56K; SM0603-R-JRL; Digikey P56.0KCCT-ND
R49: 1.5M; SM0603-R-JRL; Digikey P1.50MCCT-ND
R51, R67, R72, R85, R115: 10K; SM0603-R-JRL; Digikey P10.0KCCT-ND
R53: 270; SM0603-R-JRL; Digikey P10.0KCCT-ND
R55: 22K; SM0603-R-JRL; Digikey P10.0KCCT-ND
R57, R80, R126: 4.7K; SM0603-R-JRL; Digikey P10.0KCCT-ND
R58, R82: 1.8K; SM0603-R-JRL; Digikey P10.0KCCT-ND
R59, R118, R119: 1meg; SM0603-R-JRL; Digikey P10.0KCCT-ND
R60, R69, R98, R102: 10k; SM0603-R-JRL; Digikey P10.0KCCT-ND
R61: 3.3K; SM0603-R-JRL; Digikey P10.0KCCT-ND
R63: 220K; SM0603-R-JRL; Digikey P10.0KCCT-ND
R66: 12K; SM0603-R-JRL; Digikey P10.0KCCT-ND
R68, R84: 30K; SM0603-R-JRL; Digikey P10.0KCCT-ND
R83: 8.2K; SM0603-R-JRL; Digikey P10.0KCCT-ND
R88: 68K; SM0603-R-JRL; Digikey P91.0KCCT-ND
R90, R113, R125: 1K; SM0603-R-JRL; Digikey P10.0KCCT-ND
R91, R95, R121, R135, R138: 15K; SM0603-R-JRL; Digikey P10.0KCCT-ND
R92, R128: 1meg; SM0603-R-JRL
R96: 22K; SM0603-R-JRL; Digikey P91.0KCCT-ND
R99, R136, R145, R146, R147: 47K; SM0603-R-JRL
R100, R116, R137: 15K; SM0603-R-JRL
R107: 100; SM0603-R-JRL
R112: 330K; SM0603-R-JRL; Digikey P10.0KCCT-ND
R114: 6.8K; SM0603-R-JRL
R117: 22K; SM0603-R-JRL
R120: 10K; SM0603-R-JRL; Digikey P91.0KCCT-ND
R123: 3.3K; SM0603-R-JRL
R127: 180K; SM0603-R-JRL; Digikey P10.0KCCT-ND
R130: 1K; SM0603-R-JRL; Digikey P91.0KCCT-ND
R132, R134: 330; SM0603-R-JRL
R140: 100; SM0603-R-JRL; Digikey P10.0KCCT-ND
R143: 220K; SM0603-R-JRL
R149: 120K; SM0603-R-JRL
SW1, SW2, SW4: SPDT; SS-12F108-1P2T-SLIDE
SW3: BF3-1050; B3F-1050-OMRON
SW5: DP6T-ALPHA-SR2511; SR2511-ALPHA
TC1: 1K 3300ppm/K; SM0805-HAND
TP1, TP2, TP3, TP4, TP6, TP7, TP8, TP10: TEST_POINT; TEST_POINT_5000_SERIES
TP5, TP9: CONN_1; TEST_POINT_LOOP_4592
U1, U2, U3, U9, U10, U19: TL072-; TSSOP8-JRL
U4: CD40106; TSSOP-14_4.4x5mm_Pitch0.65mm
U5: CD4027; TSSOP-16_4.4x5mm_Pitch0.65mm
U6, U7, U8: LM13700; SO16-JRL
U11: TL072-; TSSOP-8_4.4x3mm_Pitch0.65mm
U12, U13, U14, U15, U16, U18, U21: TA75S558F; SOT753_TSOP5_SC-74A
U17: CD4052; TSSOP-16_4.4x5mm_Pitch0.65mm
U20: CD4013; TSSOP-14_4.4x5mm_Pitch0.65mm
VR1, VR2, VR20, VR21, VR22: 50K(A); RD901F-ALPHA-POT-T18
VR3: 100; TC33X-2
VR4, VR5, VR6, VR15: 50K; RD901F-ALPHA-POT-T18
VR7, VR11, VR16, VR25: 100K; TC33X-2
VR8, VR26: 100K; RD901F-ALPHA-POT-T18
VR9, VR10: 100K(A); RD901F-ALPHA-POT-T18
VR12: 10K; Bourns-3296W
VR13: 20K; Bourns-3296W
VR14, VR24: 22K; TC33X-2
VR17, VR18, VR19: 50K(B); RD901F-ALPHA-POT-T18
VR23: 100K(B); TC33X-2
VR27, VR28: 10K; TC33X-2

Connections:
+10V: C49.1, D1.1 (K), R3.2, R25.2, R49.2, R55.2, R71.2, R115.2, VR3.2, VR3.3, VR5.3, VR7.3, VR8.3, VR16.1
+12V: C27.1, C29.1, C31.1, C34.1, C37.1, C39.1, C41.1, C43.1, C45.1 (+), C47.1, C50.1, D16.1 (K), D17.1 (K), F1.2, Q2.2 (S), Q5.2 (S), Q9.2 (S), Q10.2 (S), Q15.3 (C), R3.1, R61.2, R66.2, R83.2, R107.2, R120.1, R123.1, R131.2, R133.2, R136.2, R143.2, U1.8 (V+), U2.8 (V+), U3.8 (V+), U4.14 (VDD), U5.5 (K), U5.6 (J), U5.10 (J), U5.11 (K), U5.16 (VDD), U6.11 (V+), U7.11 (V+), U8.11 (V+), U9.8 (V+), U10.8 (V+), U11.8 (V+), U12.5 (V+), U13.5 (V+), U14.5 (V+), U15.5 (V+), U16.5 (V+), U17.16 (VDD), U18.5 (V+), U19.8 (V+), U20.14 (VDD), U21.5 (V+), VR17.3, VR23.1, VR28.1
-5V: D2.2 (A), R4.2, U17.7 (VEE)
-10V: D4.2 (A), R11.2, VR7.1, VR8.1, VR11.3, VR16.3
-12V: C28.2, C30.2, C32.2, C35.2, C38.2, C40.2, C42.2, C44.2, C46.2 (-), C48.2, C51.2, D18.2 (A), F2.2, P3.3, R4.1, R11.1, R41.1, R45.2, R52.1, R70.1, R101.1, R103.1, R112.2, R144.2, R149.2, U1.4 (V-), U2.4 (V-), U3.4 (V-), U6.6 (V-), U7.6 (V-), U8.6 (V-), U9.4 (V-), U10.4 (V-), U11.4 (V-), U12.2 (V-), U13.2 (V-), U14.2 (V-), U15.2 (V-), U16.2 (V-), U18.2 (V-), U19.4 (V-), U21.2 (V-), VR23.3
Iabc: Q3.5 (C), R36.2, R48.2, R64.2, R94.2
KYBD: J5.2, J8.3, R28.1
unnamed: C1.1, J1.3
unnamed: C1.2, D3.1 (K), Q1.1 (B), R8.2
unnamed: C2.1 (+), C3.1, R15.1, U12.3 (-)
unnamed: C2.2 (-), R9.2, R10.2
unnamed: C3.2, C4.2, R15.2, R24.1, U12.4
unnamed: C4.1, R17.1
unnamed: C5.1, R34.2, U9.1, VR12.2, VR12.3
unnamed: C5.2, R18.1, R19.1, R20.1, R21.1, R25.1, R33.2, U9.2 (-)
unnamed: C6.1, Q2.3 (G), U6.5
unnamed: C7.1, R37.2, R47.1, U1.1
unnamed: C7.2, R27.2, R28.2, R29.2, R30.2, R31.2, R32.2, U1.2 (-), VR13.2, VR13.3
unnamed: C8.1, R44.2, U14.4
unnamed: C8.2, Q3.4 (C), R45.1, U14.3 (-)
unnamed: C9.1, Q4.5 (C), R49.1, U1.6 (-)
unnamed: C9.2, R51.1, U1.7
unnamed: C10.1, Q5.3 (G), U6.12
unnamed: C11.1, Q6.2 (S), R53.2
unnamed: C11.2, D5.1 (K), Q6.1 (D), R57.1, R58.1, R60.1, R62.1, R138.1, TP2.1, U2.1
unnamed: C12.1, D6.1 (K), U2.7
unnamed: C12.2, R58.2, U2.5 (+)
unnamed: C13.1, Q9.3 (G), U7.5
unnamed: C15.1 (+), P5.2, R87.2, U8.3 (+)
unnamed: C15.2 (-), P5.1, R77.2, R78.2, R79.2
unnamed: C16.1, R73.2, R75.2, R76.2, R88.1, U10.2 (-)
unnamed: C16.2, R88.2, R96.1, U10.1, VR25.3
unnamed: C17.1, R83.1, R84.2, R91.1, U15.3 (-)
unnamed 33: C17.2, R72.1, R91.2, R98.1, TP7.1, U15.4; also elsewhere on the board
unnamed: C18.1, R90.2, R95.1, U3.6 (-)
unnamed: C18.2, R95.2, R102.1, TP8.1, U3.7
unnamed: C19.1, Q10.3 (G), U7.12
unnamed: C20.1, R5.1, R143.1, U19.2 (-)
unnamed: C20.2, D20.2 (A), U19.1
unnamed: C21.1 (+), R108.2
unnamed: C21.2 (-), Q10.1 (D), R97.1, R101.2, SW1.3 (C)
unnamed: C22.1, R110.1, U8.5, U16.3 (-)
unnamed: C22.2, R110.2, R113.1, R118.2, R128.2, TP3.1, U11.3 (+), U16.4
unnamed: C23.1 (+), R122.1
unnamed: C23.2 (-), SW1.2 (B), TP4.1
unnamed: C24.1, R122.2, R127.1, U18.3 (-)
unnamed: C25.1, D14.1 (K), Q15.1 (B)
unnamed: C26.1 (+), Q11.3 (C), R99.2, R107.1
unnamed: C33.1, R131.1, R134.1, U4.3 (In)
unnamed: C36.1, D16.2 (A), R132.2, R133.1
unnamed: D3.2 (A), P3.2, Q1.2 (E), R8.1
unnamed: D6.2 (A), Q6.3 (G), R57.2
unnamed: D8.1 (K), D9.2 (A), R72.2, R82.2, U3.5 (+)
unnamed: D10.2 (A), U17.1 (Y0)
unnamed: D11.2 (A), U17.5 (Y1)
unnamed: D12.2 (A), U17.2 (Y2)
unnamed: D13.2 (A), U17.4 (Y3)
unnamed: D14.2 (A), U11.1
unnamed: D15.2 (A), R126.2
unnamed: D19.1 (K), U11.7
unnamed: D19.2 (A), R130.2, U11.6 (-)
unnamed: D20.1 (K), R144.1, U20.3 (Cp)
unnamed: D21.1 (K), D22.1 (K), P6.3
unnamed: D21.2 (A), P6.1, R145.2
unnamed: D22.2 (A), P6.5, R146.2
unnamed: F1.1, P2.9, P2.10
unnamed: F2.1, P2.1, P2.2
unnamed: J2.3, VR1.3
unnamed: J3.3, VR2.3
unnamed: J4.3, R13.2, VR4.3
unnamed: J5.3, VR6.3
unnamed: J6.3, VR9.3
unnamed: J7.3, VR10.3
unnamed: J9.2, VR14.1
unnamed: J9.3, VR15.3
unnamed: J10.3, VR18.3
unnamed: J11.3, VR19.3
unnamed: J12.3, VR20.3
unnamed: J13.3, VR21.3
unnamed: J14.3, VR22.3
unnamed: J15.2, R115.1
unnamed: J15.3, VR26.3
unnamed: J16.3, R125.2
unnamed: J17.3, R129.1
unnamed: J18.3, R113.2
unnamed: P1.1, R12.1, VR3.1
unnamed: P1.2, R7.1, R12.2
unnamed: P1.3, R6.1, R7.2
unnamed: P1.4, R2.1, R6.2
unnamed: P1.5, R1.1, R2.2
unnamed: P1.8, U13.1 (+)
unnamed: P4.1, SW5.2
unnamed: P4.2, SW5.1
unnamed: P4.3, SW5.12
unnamed: P4.4, SW5.11
unnamed: P4.5, SW5.10
unnamed: P4.6, P4.7, SW5.9
unnamed: P4.8, SW5.A
unnamed: P6.2, P6.4, P6.6, R147.2
unnamed: Q1.3 (C), R135.1, SW4.2 (B)
unnamed: Q2.1 (D), R39.1, R41.2, R43.2
unnamed: Q3.1 (B), R35.2, R40.2, R42.2, TP1.1
unnamed: Q3.2 (E), R44.1
unnamed: Q4.1 (B), R47.2, TC1.1
unnamed: Q4.2 (E), R51.2
unnamed: Q4.4 (C), R53.1, U2.2 (-)
unnamed: Q5.1 (D), R50.1, R52.2, R54.2, R106.2
unnamed: Q7.1 (B), R138.2, R139.2
unnamed: Q7.2 (E), Q8.1 (B), R61.1
unnamed: Q8.2 (E), R67.2
unnamed: Q8.3 (C), R66.1, R68.2, U15.1 (+)
unnamed: Q9.1 (D), R65.1, R70.2, R74.2
unnamed: Q11.1 (B), R96.2, R100.2, VR24.1
unnamed: Q11.2 (E), Q12.1 (B), R103.2
unnamed: Q12.3 (C), SW2.1 (A)
unnamed: Q13.1 (B), U10.7
unnamed: Q13.2 (E), R114.2, U10.6 (-)
unnamed: Q13.3 (C), SW2.3 (C)
unnamed: Q14.2 (E), VR27.1
unnamed: Q14.3 (C), U8.16
unnamed: Q15.2 (E), R126.1
unnamed: R9.1, VR1.2
unnamed: R10.1, VR2.2
unnamed: R13.1, R16.2, U9.6 (-)
unnamed: R14.2, U12.1 (+)
unnamed: R16.1, R18.2, U9.7
unnamed: R17.2, R22.2, R23.2
unnamed: R19.2, VR6.2
unnamed: R20.2, VR5.2
unnamed: R21.2, VR7.2
unnamed: R24.2, R26.2, R39.2, U6.4 (-), U8.12
unnamed: R27.1, TP10.1, U13.3 (-), U13.4
unnamed: R29.1, VR8.2
unnamed: R30.1, VR9.2
unnamed: R31.1, VR10.2
unnamed: R32.1, VR11.2
unnamed: R33.1, VR12.1
unnamed: R34.1, R35.1, R38.2
unnamed: R36.1, U6.1
unnamed: R37.1, VR13.1
unnamed: R38.1, R40.1
unnamed: R43.1, R46.2, R50.2, U6.13 (-)
unnamed: R48.1, U6.16
unnamed: R54.1, R56.2, R65.2, U7.4 (-)
unnamed: R55.1, VR14.2, VR14.3
unnamed: R59.1, VR16.2
unnamed: R63.1, VR15.2
unnamed: R64.1, U7.1
unnamed: R73.1, VR17.2
unnamed: R74.1, R81.2, R97.2, U7.13 (-)
unnamed: R75.1, VR18.2
unnamed: R76.1, VR19.2
unnamed: R77.1, VR20.2
unnamed: R78.1, VR21.2
unnamed: R79.1, VR22.2
unnamed: R92.1, R93.2, U8.4 (-)
unnamed: R92.2, VR23.2
unnamed: R94.1, U7.16
unnamed: R99.1, VR24.2
unnamed: R104.2, VR25.1
unnamed: R105.1, U8.1
unnamed: R105.2, SW2.2 (B)
unnamed: R106.1, SW1.1 (A)
unnamed: R108.1, R111.2, U8.13 (-)
unnamed: R23.1, R109.1, U8.14 (+)
unnamed: R59.2, R62.2, R63.2, R112.1, R117.2, U3.2 (-)
unnamed: R116.2, R120.2, U11.2 (-)
unnamed: R118.1, R119.2, U11.5 (+)
unnamed: R121.1, VR26.2
unnamed: R121.2, VR27.2, VR27.3
unnamed: R123.2, U17.3 (Y)
unnamed: R124.2, U18.1 (+)
unnamed: R125.1, U21.3 (-), U21.4
unnamed: R132.1, U4.1 (In)
unnamed: R134.2, SW3.1
unnamed: R136.1, U8.2
unnamed: R137.2, U10.3 (+)
unnamed: R139.1, VR28.2
unnamed: R140.1, R142.1, U3.3 (+)
unnamed: R141.2, VR28.3
unnamed: R80.1, R142.2, U3.1
unnamed: R145.1, U20.13 (Q)
unnamed: R146.1, U20.1 (Q), U20.11 (Cp)
unnamed: R147.1, R149.1, U19.5 (+)
unnamed: R148.2, R150.1, U19.6 (-)
unnamed: U4.2 (Out), U5.4 (Cd), U5.12 (Cd)
unnamed: U4.4 (Out), U5.3 (Cp)
unnamed: U5.2 (~Q), U5.13 (Cp)
unnamed: U9.5 (+), VR4.2
unnamed: U10.5 (+), VR25.2
unnamed: U5.15 (Q), U17.9 (B)
unnamed: U5.1 (Q), U17.10 (A)
unnamed: U20.2 (~Q), U20.5 (D)
unnamed: U20.9 (D), U20.12 (~Q)
SUB_OSC: J3.2, R150.2, U19.7
SYNC: C14.1, R69.2, R71.1, R135.2, SW4.1 (A), U2.6 (-)
VCF: C24.2, J12.2, R127.2, R129.2, U18.4
VCO: J2.2, U17.13 (X), U21.1 (+)
VCO_PULSE: D7.1 (K), R80.2, R85.2, TP6.1, U17.12 (X0), U19.3 (+)
VCO_SAW: R60.2, U17.14 (X1)
VCO_SINE: R102.2, U17.11 (X3)
VCO_TRI: R98.2, U17.15 (X2)

Notes on the sheet:
or J112?
VCO
NPN here is 2SC752-Y
8.2V reset point
'Ultrafast' switching BJT
PMBT2369 seems like very close substitute, even slightly faster
MULTI- TURN
set initial pitch
FINE
DUTY 50% ADJUST
DUTY 5% ADJUST
PWM
check polarity
VCF
FREQUENCY TRIM
FREQUENCY
BIPOLAR FREQ CV
UNIPOLAR FREQ CV
RESONANCE
RES TRIM
USE TOSHIBA MATCHED PAIR
Does CV summer need conditioned rails? Use a rail-rail opamp here?
00 PULSE 01 SAW 10 TRI 11 SINE
POWER ON RESET
SWITCH DEBOUNCE
GROUND UNUSED CMOS INPUTS
RESET FLIP FLOPS TO '00' ON POWER UP
VCF WIDTH
INITIAL GAIN
POWER
VCA
SYNC
ROTARY SWITCH GOES ON SUB BOARD
JP8 SYNC
810
VCA OUT
VCF OUT
VCO OUT
WEAK
STRONG
-12V for JP8 sync GND for M-112 sync
OCTAVE SWITCH
24 dB
12 dB
R95 CHANGED TO 15K
R91 CHANGED TO 15K
CHANGE R73 to 150K
CHANGE R15 to 100K
CHANGE R15 to 180K
CHANGE R105 to 100K
DELETE R5, C1: 100p R8: 100K - see M-112 SYNC
R18: 200K
R19: 200K
R19: 180K
VR12: 20K
USE +10V REF HERE?
TRI SYM
KEEP Iabc(max) < 200 μA
EXP
LIN
SH101 SUB OSCILLATOR FROM: http://electro-music.com/forum/topic-18983.html
2_OCT_DOWN_SQUARE
2 OCT DOWN PUSLE
1_OCT_DOWN_SQUARE
CLOCK GENERATOR FOR CD4013. THIS WAS TRICKY ON BREADBOARD WORKS WITH PULSE BUT NOT TRI.
LEVEL SHIFTER
CHANGE TO 0603 FOR PRODUCTION
DELETE TRIMMER?
CHANGE R88 to 47K?
DELETE OR REDUCE C14
100R?
100K?
Needs to be buffered!
330R?

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
