minisystem/810/810.kicad_pcb

## KiCad design 810.kicad_pcb (continued)

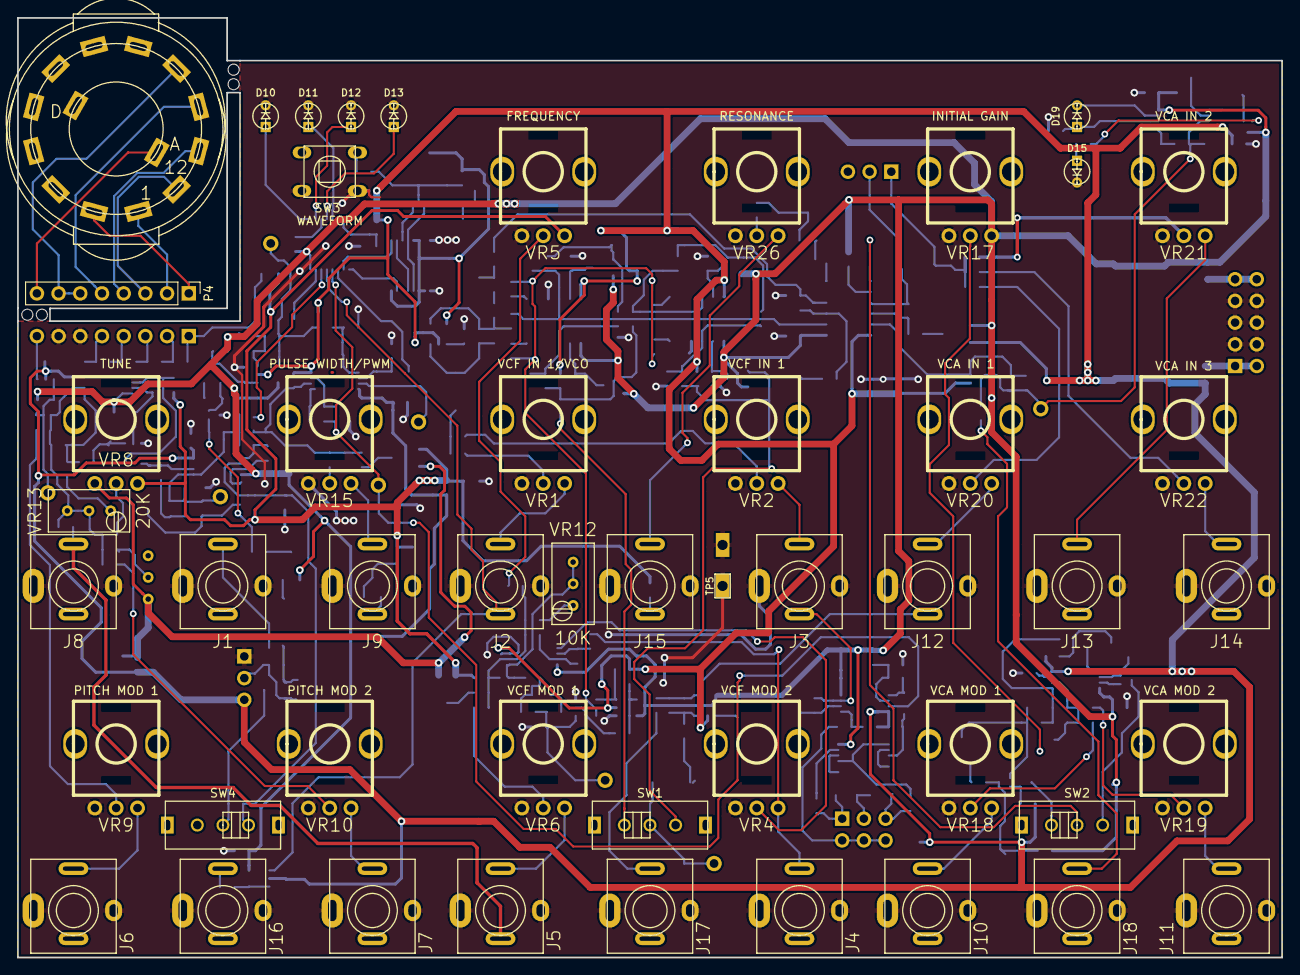
[picture p21: board 810.kicad_pcb from above]

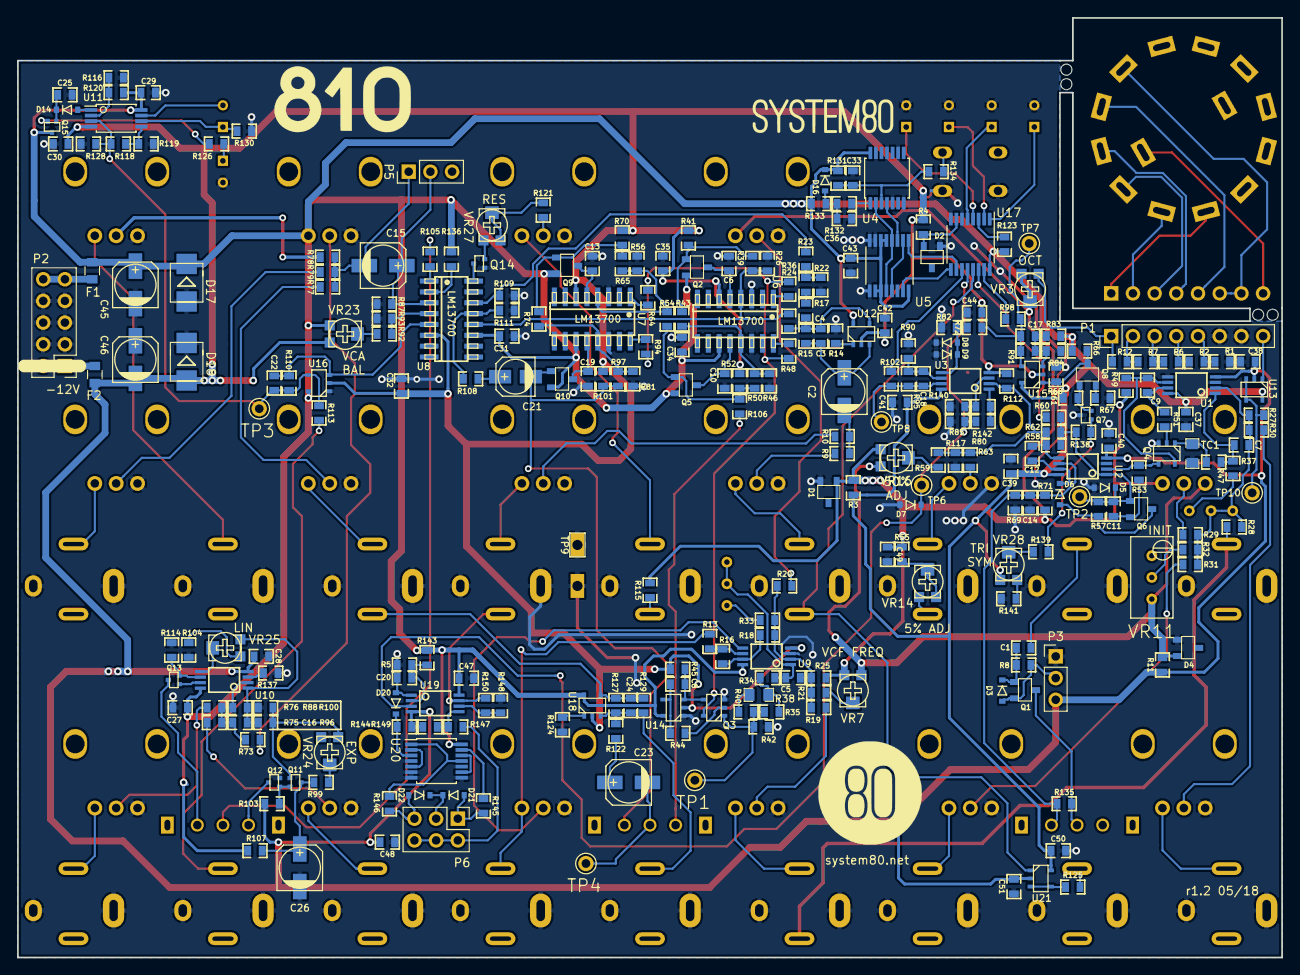
[picture p22: board 810.kicad_pcb from below]

Board: 2 copper layers, 148.0 x 110.0 mm, 331 parts (282 on the bottom side), 203 nets.

Other parts of the board:
TP7#2, TP7#3, TP7#4, TP7#5: TEST_POINT; TEST_POINT_5000_SERIES

Their connections:
unnamed 33: TP7#5.1; also elsewhere on the board
