minisystem/810/(commit log)

2017-07-17 changed to Toshiba matched pairs, added 12dB/24dB selector switch
    [810.sch]
2017-07-18 gibber jabber
    [810.sch]
2017-08-22 finishing off, tidying up
    [810.sch]
2017-08-23 added bi-color LED level indicator circuit
    [810.sch]
2017-09-01 annotated and ERC done
    [810.sch]
2017-09-25 panel update from mac pro
    [810_hole_centres.dxf]
2017-09-25 pcbnew file created, pots/jacks/switches placed
    [810.sch]
2017-09-26 added hard/soft sync switch
    [810.kicad_pcb, 810.sch]
2017-10-13 updated SW1 rotary switch footprint to Alpha SR2511
    [810.kicad_pcb, 810.sch]
2017-10-23 started PCB part placement
    [810.kicad_pcb]
2017-10-29 more part placement. done VCO and VCF, started VCA
    [810.kicad_pcb, 810.sch]
2017-11-03 added rotary switch, integrated into main PCB
    [810.kicad_pcb, 810.sch]
2017-11-06 main power rails routed
    [810.kicad_pcb]
2017-11-06 placed and routed previously unplaced C7
    [810.kicad_pcb]
2017-11-11 all components placed, mostly routed
    [810.kicad_pcb]
2017-11-12 routed, yo
    [810.kicad_pcb]
2017-11-19 changed a bunch of wrong footprints and added gitignore
    [810.kicad_pcb, 810.sch]
2017-11-21 finesse references, ongoing
    [810.kicad_pcb, 810.sch]
2017-11-22 more silkscreen work
    [810.kicad_pcb]
2018-01-15 changes to schematic for next revision, not yet implemented in PCB
    [810-B.Paste.dxf, 810.kicad_pcb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]
2018-01-16 schematic changes updated in PCB, routed
    [810.kicad_pcb, 810.sch]
2018-01-17 more routing and tweaking. Still need to change 2SK208 footprints
    [810.kicad_pcb, 810.sch]
2018-01-22 added secret sub-oscillator
    [810.kicad_pcb, 810.sch]
2018-01-23 board tweaking, getting ready to match up with panel art and order second prototype
    [810.kicad_pcb]
2018-01-25 changes switches to horizontal position
    [810.kicad_pcb]
2018-01-26 ordered PCB v1-1
    [810.kicad_pcb, 810.sch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]
2018-02-17 couple of changes to schematic to reflect updated part values in r1.1 build
    [810.kicad_pcb, 810.sch]
2018-02-20 more notes from v1.1 build. sync reset problem with C14 fixed
    [810.sch]
2018-02-21 sync from Mac Pro
    [810_panel_dimensioned.dwg]
2018-02-21 update from PC with hopefully fixed dxf mechanical
    [810_holes_centres_export_from_drawing.dxf, 810_panel_mechanical.dxf]
2018-02-22 fixed position of middle switch, offset by 0.5 mm
    [810.kicad_pcb]
2018-02-22 update from mac pro
    [810_panel_mechanical.dwg]
2018-02-23 updated dimensioned 810 panel drawing"
    a
    [810_panel_dimensioned.dwg, 810_panel_mechanical.dwg]
2018-04-24 ground plane stiching and tweaking
    [810.kicad_pcb, 810.sch]
2018-04-26 changed TRI and SINE waveshapers - tested and working
    [810.kicad_pcb, 810.sch]
2018-04-28 beefed up rail traces, replaced pwm rail references with +10V ref
    [810.kicad_pcb, 810.sch]
2018-04-28 bit more silk screen tweaking, then 2 layer version is done
    [810.kicad_pcb]
2019-04-07 manual updates from Mac Pro
    [810_panel_dimensioned.dwg]
